SkyEngineer/sensor_current_stand/3 Elektronik/0. Datasheet/ST-LINK V2 China pinout.bmp

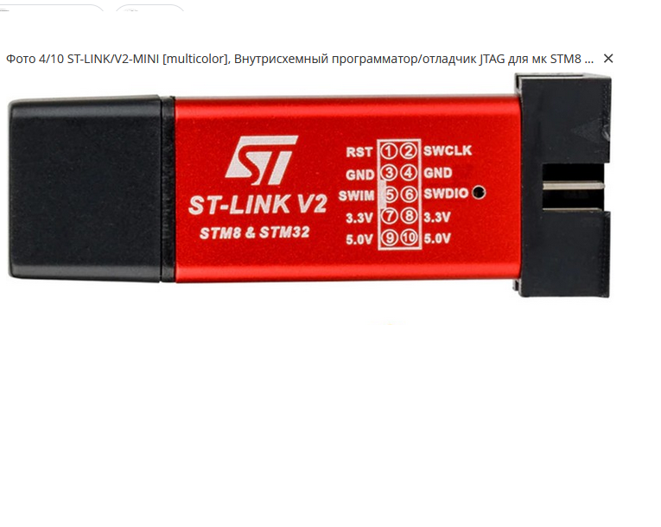
3 Elektronik/0. Datasheet/ST-LINK V2 China pinout.bmp
