SkyEngineer/sensor_current_stand/Mail/19.04.2024/Перспектива.bmp

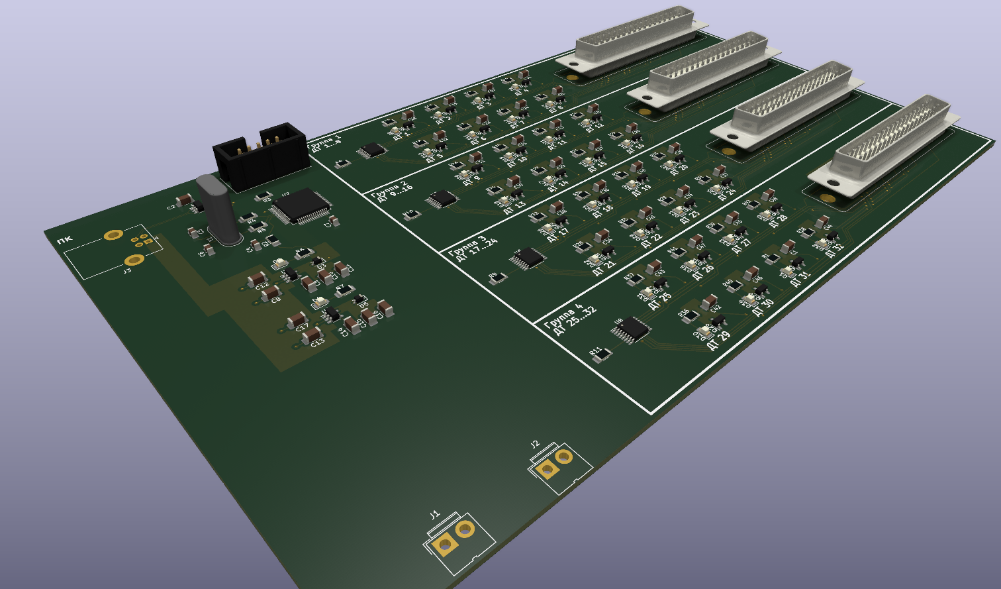
Mail/19.04.2024/Перспектива.bmp
