SkyEngineer/sensor_current_stand/3 Elektronik/Probe/Readme.txt

экспериментируем чтобы понять какое падение напряжения будет при тока в 40 мА максимум.

У меня есть только источник 5 В, для получения тока в 40 мА нужно взять сопротивление нагрузки в 5/0,040 = 125 Ом.
