SkyEngineer/sensor_current_stand/5_Soft/1. Embedded_SW/0. Beispielen/Readme.txt

Keil
https://rutracker.org/forum/viewtopic.php?t=6294452

USB
https://microtechnics.ru/mikrokontroller-stm32-i-usb/

https://microtechnics.ru/stm32cube-i-usb-virtual-com-port/
