SkyEngineer/sensor_current_stand/5_Soft/2_Desktop_SW/Работа с приборами.docx

# 1 Вольтметр

Идентификация:

Получение данных замера постоянного напряжения:

MEASure[:VOLTage]:{AC|DC}?

MEAS:VOLT:DC?

Рестарт измерений

CALCulate:CLEar[:IMMediate]

Шкала

Конфигурация измерений

CONFigure[:VOLTage]:{AC|DC} [{<range>|AUTO|MIN|MAX|DEF}]

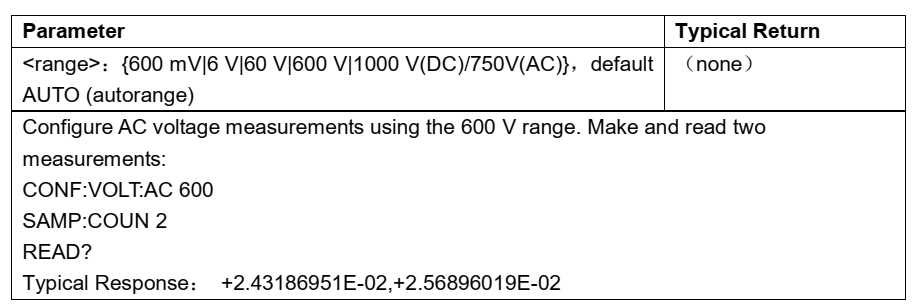
[picture p3: figure]

Выбор измерения

FUNC "VOLT:DC”

# 2 Источник измеряемого тока

# 3 Источник питания датчиков
