SkyEngineer/sensor_current_stand/со стенда/DT_100_Autotest/Template/Template_report.xlsx

Sheet: Данные
Номер датчика | Исправность датчика | Uпит, В | Iпит, mA | Uизм, В (0 А) | Uизм, В (20 А) | Uизм, В (40 А) | Uизм, В (60 А) | Uизм, В (80 А) | Uизм, В (100 А)

Sheet: Доп. данные
Время | Действие
