SkyEngineer/sensor_current_stand/со стенда/DT_500_Autotest/Template/Template_report.xlsx

Sheet: Данные
Номер датчика | Исправность датчика | Uпит, В | Iпит, mA | Uизм, В (0 А) | Uизм, В (100 А) | Uизм, В (200 А) | Uизм, В (300 А) | Uизм, В (400 А) | Uизм, В (500 А)

Sheet: Доп. данные
Время | Действие
