SkyEngineer/sensor_current_stand/5_Soft/2_Desktop_SW/DT_500_Autotest v2/Template/Template_report.xlsx

Sheet: Данные
Группа датчиков | Номер датчика | Исправность датчика | Uпит, В | Iпит, mA | Uизм, В (0 А) | Uизм, В (100 А) | Uизм, В (200 А) | Uизм, В (300 А) | Uизм, В (400 А) | Uизм, В (500 А)
1 | 1 |  | 16.0
 |  |  | 27.0
 |  |  | 32.0
 | 2 |  | 16.0
 |  |  | 27.0
 |  |  | 32.0
 | 3 |  | 16.0
 |  |  | 27.0
 |  |  | 32.0
 | 4 |  | 16.0
 |  |  | 27.0
 |  |  | 32.0
 | 5 |  | 16.0
 |  |  | 27.0
 |  |  | 32.0
 | 6 |  | 16.0
 |  |  | 27.0
 |  |  | 32.0
 | 7 |  | 16.0
 |  |  | 27.0
 |  |  | 32.0
 | 8 |  | 16.0
 |  |  | 27.0
 |  |  | 32.0
2 | 9 |  | 16.0
 |  |  | 27.0
 |  |  | 32.0
 | 10 |  | 16.0
 |  |  | 27.0
 |  |  | 32.0
 | 11 |  | 16.0
 |  |  | 27.0
 |  |  | 32.0
 | 12 |  | 16.0
 |  |  | 27.0
 |  |  | 32.0
 | 13 |  | 16.0
 |  |  | 27.0
 |  |  | 32.0
 | 14 |  | 16.0
 |  |  | 27.0
 |  |  | 32.0
 | 15 |  | 16.0
 |  |  | 27.0
 |  |  | 32.0
 | 16 |  | 16.0
 |  |  | 27.0
 |  |  | 32.0
3 | 17 |  | 16.0
 |  |  | 27.0
 |  |  | 32.0
 | 18 |  | 16.0
 |  |  | 27.0
 |  |  | 32.0
 | 19 |  | 16.0
 |  |  | 27.0
 |  |  | 32.0
 | 20 |  | 16.0
 |  |  | 27.0
 |  |  | 32.0
 | 21 |  | 16.0
 |  |  | 27.0
 |  |  | 32.0
 | 22 |  | 16.0
 |  |  | 27.0
 |  |  | 32.0
 | 23 |  | 16.0
 |  |  | 27.0
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
