SkyEngineer/sensor_current_stand/0 Vom Auftraggeber/17.05.2024/Внешний вид платы.bmp

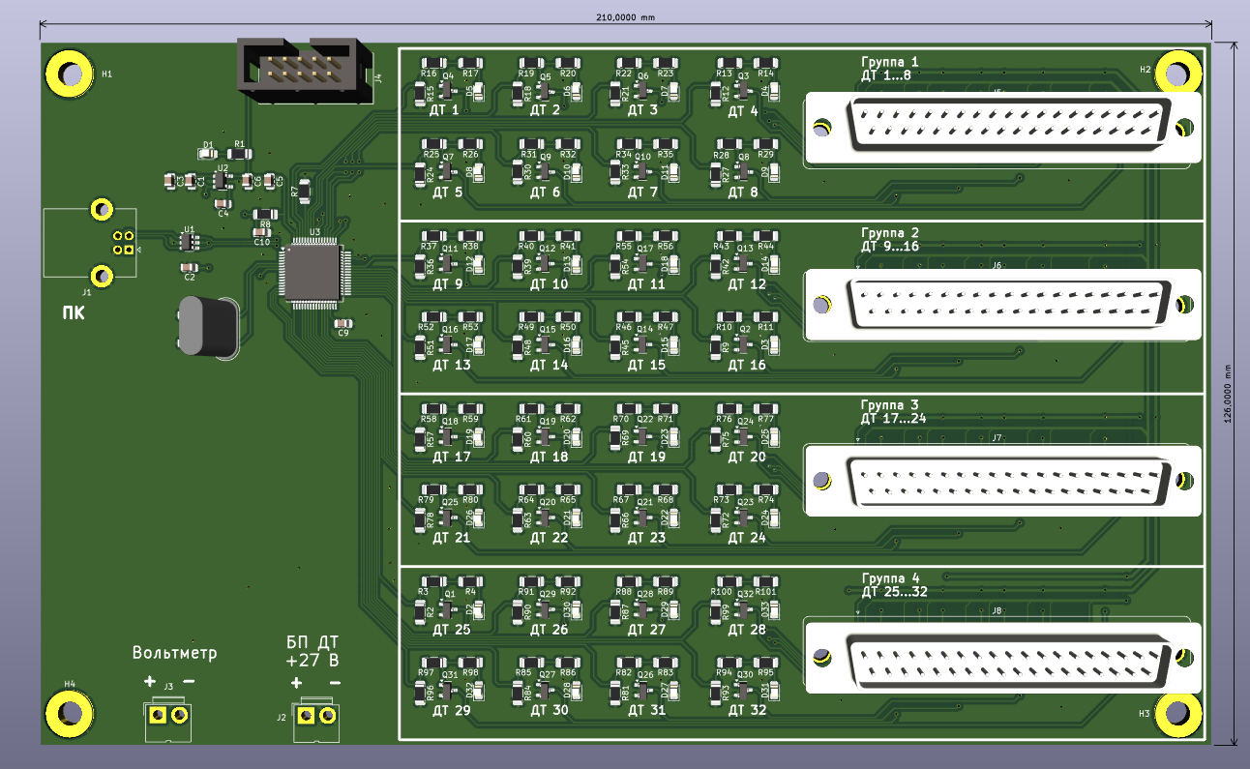
0 Vom Auftraggeber/17.05.2024/Внешний вид платы.bmp
