SkyEngineer/sensor_current_stand/3 Elektronik/Предварительное изготовление платы РЕЗОНИТ.bmp

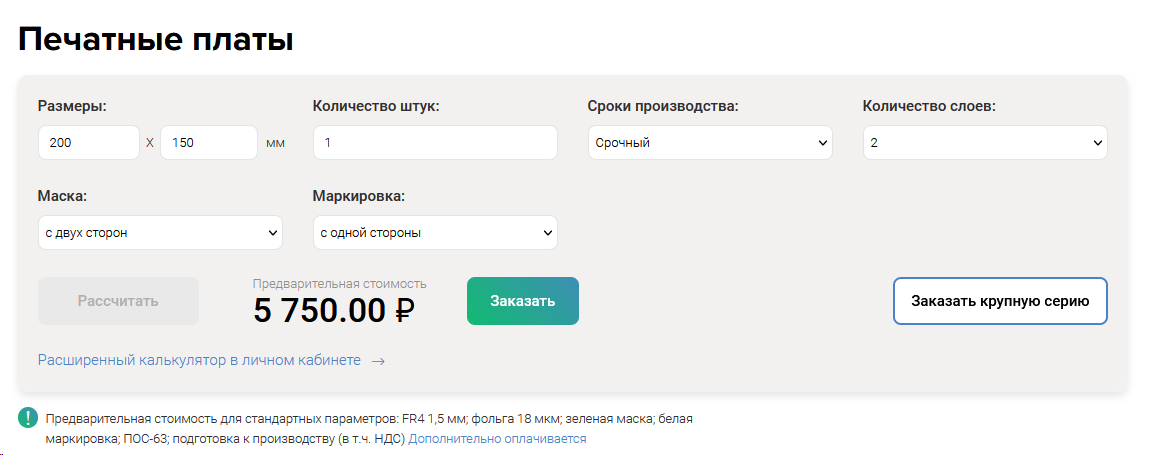
3 Elektronik/Предварительное изготовление платы РЕЗОНИТ.bmp
