SkyEngineer/sensor_current_stand/Mail/19.04.2024/Вид сверху.bmp

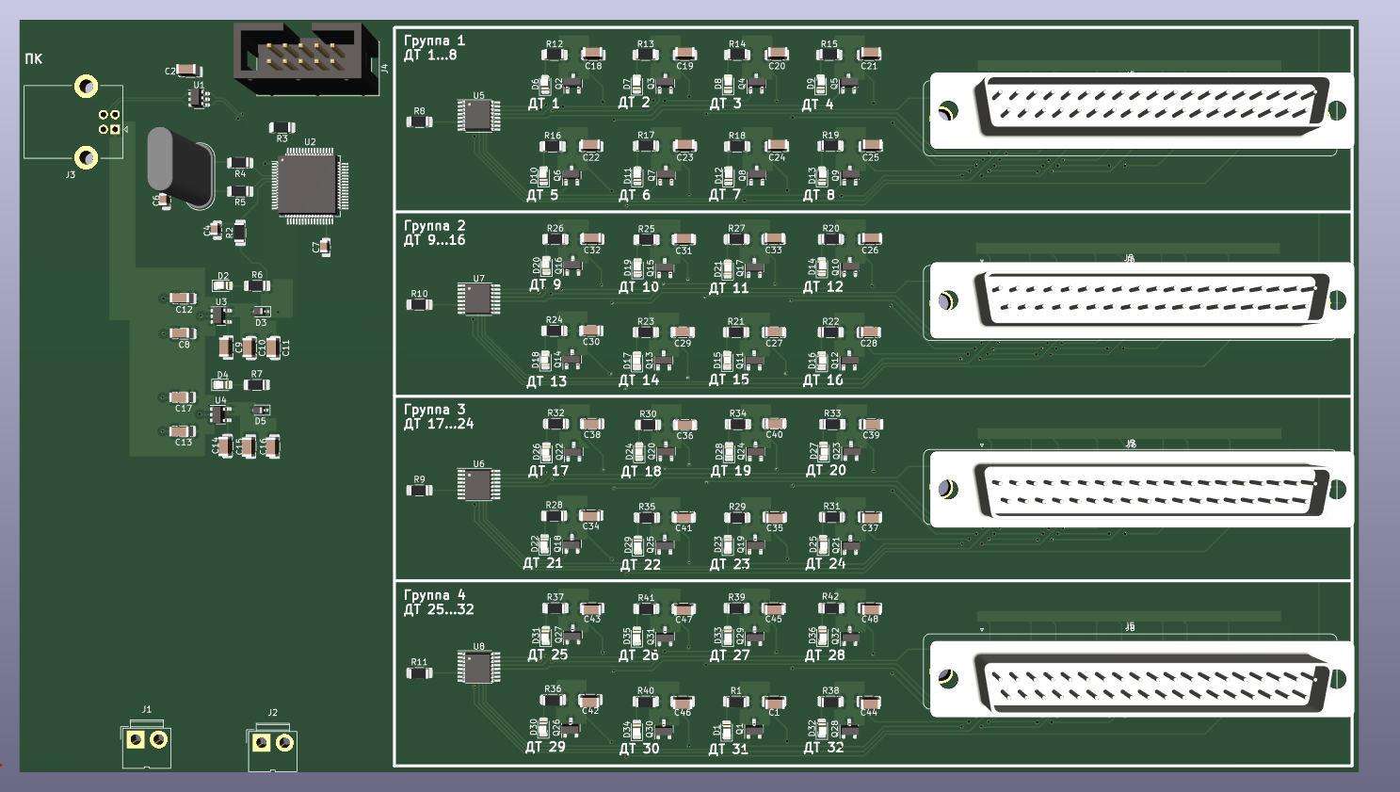
Mail/19.04.2024/Вид сверху.bmp
