SkyEngineer/sensor_current_stand/3 Elektronik/Предварительный BOM.xlsx

№ | Наименование | Назначение | Количество, шт. | цена, руб | Итог | Примечание
1 | 1734346-1, Разъем USB B SMD | Обмен стенда и ПК | 1 | 240 | 240 | https://www.chipdip.ru/product/1734346-1-te
2 | 305-021-12(TB-02A), Клеммник 2-контактный, 5мм, прямой (https://www.chipdip.ru/product/305-021-12-tb-02a) | Клеммники на плату - для питания датчиков тока - для подключения вольтметра | 2 | 21 | 42 | https://www.chipdip.ru/product/305-021-12-tb-02a
3 | DPBS-37M (DS1034 37M), Вилка на плату 37pin (https://www.chipdip.ru/product/dpbs-37m) | Подключение датчиков тока | 4 | 70 | 280 | https://www.chipdip.ru/product/dpbs-37m
4 | 74HC4051M/TR, Восьмиканальный мультиплексор/ демультиплексор | управление ключами групп | 4 | 16 | 64 | https://www.chipdip.ru/product/74hc4051m-tr
5 | BAT60JFILM, Диод Шоттки 3А, 10В [SOD-323] | Защита питания USB | 4 | 18 | 72 | https://www.chipdip.ru/product/bat60jfilm
6 | 0.25Вт 1206 100 кОм, 5%, Чип резистор (SMD) | Токоограничивающие резисторы | 20 | 6 | 120 | https://www.chipdip.ru/product/0.25w-1206-100-kom-5
7 | 0.25Вт 1206 22 Ом, 5%, Чип резистор (SMD) | Токоограничивающие резисторы | 20 | 6 | 120 | https://www.chipdip.ru/product/0.25w-1206-22-om-5
8 | STM32F446RET6, Микроконтроллер ARM Cortex-M4 32-Бит 180МГц 512КБ FLASH LQFP-64(10x10) | МК | 1 | 1760 | 1760 | https://www.chipdip.ru/product/stm32f446ret6
9 | BH-10 (DS1013-10S) (IDC-10MS), Вилка на плату прямая 10pin 2.54мм | Разъем загрузки ПО и отладки ПО | 2 | 9 | 18 | https://www.chipdip.ru/product/idc-10ms
10 | LD3985M33R, Регулятор с низким падением напряжения и уровнем шума, 150мА, 3.3В | Питание МК и мультиплексоров | 2 | 90 | 180 | https://www.chipdip.ru/product/ld3985m33r
11 | KP-2012MGC, Светодиод зеленый 2х1.2х1.1мм 50мКд | Светодиоды для контроля включения датчиков и питания | 40 | 36 | 1440 | https://www.chipdip.ru/product/kp-2012mgc
12 | IRF7342TR, Транзистор 2P-MOSFET 55В 3.4А 2Вт [SOP-8] | Ключи питания | 32 | 39 | 1248 | https://www.chipdip.ru/product/irf7342tr
 |  |  |  |  | 5584
