SkyEngineer/sensor_current_stand/0 Vom Auftraggeber/28.03.2024 Описание/project УПП/ПЭ3-УПП.xls

Sheet: . Первый лист.
Перв. примен. | Поз. обозна-чение |  |  | Наименование |  |  |  | Кол. |  | Примечание
 |  |  |  | Реле
 | K1-K20 |  |  | Микротумблер MTS-101 A-2 |  |  |  | 20
Справ. № |  |  |  | Вилки
 | XP1 |  |  | Разъём PLD-20 |  |  |  | 1
 | XP2-XP20 |  |  | Разъём PLS-1 |  |  |  | 19
 |  |  |  | Розетки
 | XS1 |  |  | Клеммник 305-021-12 |  |  |  | 1
 | XS2 |  |  | Разъём BNC-7044 |  |  |  | 1
 | XS3 |  |  | Клеммник 305-021-12 |  |  |  | 1
Подп. и дата | XS4 |  |  | Клеммник 300-41-12 |  |  |  | 1
Инв. № дубл. | K21_3,K21_4 |  |  | Микротумблер MTS-101 A-2 |  |  |  | 2
 | K21_1,K21_2 |  |  | Микротумблер MTS-101 A-2 |  |  |  | 2
 | K23_3,K23_4 |  |  | Реле IM03TS |  |  |  | 2
Взам. инв.№ | K23_1,K23_2 |  |  | Реле IM03TS |  |  |  | 2
 | K24_3,K24_4 |  |  | Реле IM03TS |  |  |  | 2
Подп. и дата
 |  |  |  |  |  |  | ПЭ3
 | Изм. | Лист | № докум. |  | Подп. | Дата
Инв. № подл. | Разраб. |  |  |  |  |  |  |  | Лит. |  | Лист | Листов
 | Пров. |  |  |  |  |  |  |  |  |  | 1 | 5
 | Н.контр
 | Утв. |  |  |  |  |  | Перечень элементов

Sheet: 2
 | Поз. обозна- чение |  |  | Наименование |  |  |  | Кол. | Примечание
 | K24_1,K24_2 |  |  | Реле IM03TS |  |  |  | 2
 | K25_3,K25_4 |  |  | Реле IM03TS |  |  |  | 2
 | K25_1,K25_2 |  |  | Реле IM03TS |  |  |  | 2
 | K26_3,K26_4 |  |  | Реле IM03TS |  |  |  | 2
 | K26_1,K26_2 |  |  | Реле IM03TS |  |  |  | 2
 | K27_3,K27_4 |  |  | Реле IM03TS |  |  |  | 2
 | K27_1,K27_2 |  |  | Реле IM03TS |  |  |  | 2
 | K28_3,K28_4 |  |  | Реле IM03TS |  |  |  | 2
 | K28_1,K28_2 |  |  | Реле IM03TS |  |  |  | 2
 | K29_3,K29_4 |  |  | Реле IM03TS |  |  |  | 2
 | K29_1,K29_2 |  |  | Реле IM03TS |  |  |  | 2
 | K30_3,K30_4 |  |  | Реле IM03TS |  |  |  | 2
Подп. и дата | K30_1,K30_2 |  |  | Реле IM03TS |  |  |  | 2
 | K31_3,K31_4 |  |  | Реле IM03TS |  |  |  | 2
 | K31_1,K31_2 |  |  | Реле IM03TS |  |  |  | 2
 | K32_3,K32_4 |  |  | Реле IM03TS |  |  |  | 2
Инв. № дубл. | K32_1,K32_2 |  |  | Реле IM03TS |  |  |  | 2
 | K33_3,K33_4 |  |  | Реле IM03TS |  |  |  | 2
 | K33_1,K33_2 |  |  | Реле IM03TS |  |  |  | 2
Взам. инв.№ | K34_3,K34_4 |  |  | Реле IM03TS |  |  |  | 2
 | K34_1,K34_2 |  |  | Реле IM03TS |  |  |  | 2
 | K35_3,K35_4 |  |  | Реле IM03TS |  |  |  | 2
Подп. и дата | K35_1,K35_2 |  |  | Реле IM03TS |  |  |  | 2
 | K36_3,K36_4 |  |  | Реле IM03TS |  |  |  | 2
 | K36_1,K36_2 |  |  | Реле IM03TS |  |  |  | 2
 | K37_3,K37_4 |  |  | Реле IM03TS |  |  |  | 2
 | K37_1,K37_2 |  |  | Реле IM03TS |  |  |  | 2
Инв. № подл. | K38_3,K38_4 |  |  | Реле IM03TS |  |  |  | 2
 |  |  |  |  |  |  | ПЭ3 |  |  | Лист
 |  |  |  |  |  |  |  |  |  | 2
 | Изм. | Лист | № докум. |  | Подп. | Дата

Sheet: 3
 | Поз. обозна- чение |  |  | Наименование |  |  |  | Кол. | Примечание
 | K38_1,K38_2 |  |  | Реле IM03TS |  |  |  | 2
 | K39_3,K39_4 |  |  | Реле IM03TS |  |  |  | 2
 | K39_1,K39_2 |  |  | Реле IM03TS |  |  |  | 2
 | K40_3,K40_4 |  |  | Реле IM03TS |  |  |  | 2
 | K40_1,K40_2 |  |  | Реле IM03TS |  |  |  | 2
 | K41_3,K41_4 |  |  | Реле IM03TS |  |  |  | 2
 | K41_1,K41_2 |  |  | Реле IM03TS |  |  |  | 2
 | K42_3,K42_4 |  |  | Реле IM03TS |  |  |  | 2
 | K42_1,K42_2 |  |  | Реле IM03TS |  |  |  | 2
 | K43_3,K43_4 |  |  | Реле IM03TS |  |  |  | 2
 | K43_1,K43_2 |  |  | Реле IM03TS |  |  |  | 2
 | K44_3,K44_4 |  |  | Реле IM03TS |  |  |  | 2
Подп. и дата | K44_1,K44_2 |  |  | Реле IM03TS |  |  |  | 2
 | K45_3,K45_4 |  |  | Реле IM03TS |  |  |  | 2
 | K45_1,K45_2 |  |  | Реле IM03TS |  |  |  | 2
 | K46_3,K46_4 |  |  | Реле IM03TS |  |  |  | 2
Инв. № дубл. | K46_1,K46_2 |  |  | Реле IM03TS |  |  |  | 2
 | K47_3,K47_4 |  |  | Реле IM03TS |  |  |  | 2
 | K47_1,K47_2 |  |  | Реле IM03TS |  |  |  | 2
Взам. инв.№ | K48_3,K48_4 |  |  | Реле IM03TS |  |  |  | 2
 | K48_1,K48_2 |  |  | Реле IM03TS |  |  |  | 2
 | K49_3,K49_4 |  |  | Реле IM03TS |  |  |  | 2
Подп. и дата | K49_1,K49_2 |  |  | Реле IM03TS |  |  |  | 2
 | K50_3,K50_4 |  |  | Реле IM03TS |  |  |  | 2
 | K50_1,K50_2 |  |  | Реле IM03TS |  |  |  | 2
 | K51_3,K51_4 |  |  | Реле IM03TS |  |  |  | 2
 | K51_1,K51_2 |  |  | Реле IM03TS |  |  |  | 2
Инв. № подл. | K52_3,K52_4 |  |  | Реле IM03TS |  |  |  | 2
 |  |  |  |  |  |  | ПЭ3 |  |  | Лист
 |  |  |  |  |  |  |  |  |  | 3
 | Изм. | Лист | № докум. |  | Подп. | Дата

Sheet: 4
 | Поз. обозна- чение |  |  | Наименование |  |  |  | Кол. | Примечание
 | K52_1,K52_2 |  |  | Реле IM03TS |  |  |  | 2
 | K53_3,K53_4 |  |  | Реле IM03TS |  |  |  | 2
 | K53_1,K53_2 |  |  | Реле IM03TS |  |  |  | 2
 | K54_3,K54_4 |  |  | Реле IM03TS |  |  |  | 2
 | K54_1,K54_2 |  |  | Реле IM03TS |  |  |  | 2
 | K55_3,K55_4 |  |  | Реле IM03TS |  |  |  | 2
 | K55_1,K55_2 |  |  | Реле IM03TS |  |  |  | 2
 | K56_3,K56_4 |  |  | Реле IM03TS |  |  |  | 2
 | K56_1,K56_2 |  |  | Реле IM03TS |  |  |  | 2
 | K57_3,K57_4 |  |  | Реле IM03TS |  |  |  | 2
 | K57_1,K57_2 |  |  | Реле IM03TS |  |  |  | 2
 | K58_3,K58_4 |  |  | Реле IM03TS |  |  |  | 2
Подп. и дата | K58_1,K58_2 |  |  | Реле IM03TS |  |  |  | 2
 | K59_3,K59_4 |  |  | Реле IM03TS |  |  |  | 2
 | K59_1,K59_2 |  |  | Реле IM03TS |  |  |  | 2
 | K60_3,K60_4 |  |  | Реле IM03TS |  |  |  | 2
Инв. № дубл. | K60_1,K60_2 |  |  | Реле IM03TS |  |  |  | 2
 | XP21_3,XP21_4 |  |  | Разъём DPBS-37M |  |  |  | 2
 | XP21_1,XP21_2 |  |  | Разъём DPBS-37M |  |  |  | 2
Взам. инв.№ | XP22_3,XP22_4 |  |  | Разъём DPBS-37M |  |  |  | 2
 | XP22_1,XP22_2 |  |  | Разъём DPBS-37M |  |  |  | 2
Подп. и дата
Инв. № подл.
 |  |  |  |  |  |  | ПЭ3 |  |  | Лист
 |  |  |  |  |  |  |  |  |  | 4
 | Изм. | Лист | № докум. |  | Подп. | Дата

Sheet: Лист регистрации изменений.
 | Лист регистрации изменений
 | Изм. |  | Номера листов (страниц) |  |  |  |  |  |  |  | Всего листов (страниц) в докум. | № докум. | Входящий № сопроводи-тельного документа и дата | Под- пись | Дата
 |  |  | изменен- ных |  | заменен- ных |  | новых |  |  | аннули- рован- ных
Подп. и дата
Инв. № дубл.
Взам. инв.№
Подп. и дата
Инв. № подл.
 |  |  |  |  |  |  |  |  | ПЭ3 |  |  |  |  |  |  | Лист
 |  |  |  |  |  |  |  |  |  |  |  |  |  |  |  | 5
 | Изм. | Лист |  | № докум. |  | Подп. |  | Дата
