SkyEngineer/sensor_current_stand/5_Soft/2_Desktop_SW/Testing_DT/Readme.txt

В данном проекте используется ООП и имеются следующие объекты:
1. Технологический коммутатор (virtual com port).
2. Блок питания-измеритель для питания датчиков тока GPP-74323.
3. Блок питания-измеритель для формирования проверямого тока АКИП 1162-10-1020 или АКИП-1162-10-510 (???).
4. Вольтметр АКИП-21011 ()
