SkyEngineer/sensor_current_stand/5_Soft/2_Desktop_SW/test/pythonProject/readme.txt

    download the latest libusb Download libusb

Copy MS32\dll\libusb-1.0.dll to C:\Windows\SysWOW64

Copy MS64\dll\libusb-1.0.dll to C:\Windows\System32

3.

pip install libusb

Copy MS32\dll\libusb-1.0.dll to C:\Python\Python37-32\Lib\site-packages\libusb_platform_windows\x86

Copy MS64\dll\libusb-1.0.dll to C:\Python\Python37-32\Lib\site-packages\libusb_platform_windows\x64

This method works for me.
