SkyEngineer/sensor_current_stand/(list of files, drawings)

Other design files:
0 Vom Auftraggeber/28.03.2024 Описание/project УПП/Группа 1.SchDoc
0 Vom Auftraggeber/28.03.2024 Описание/project УПП/Группа 2.SchDoc
0 Vom Auftraggeber/28.03.2024 Описание/project УПП/Группа 3.SchDoc
0 Vom Auftraggeber/28.03.2024 Описание/project УПП/Группа 4.SchDoc
0 Vom Auftraggeber/28.03.2024 Описание/project УПП/УПП.PrjPcb
0 Vom Auftraggeber/28.03.2024 Описание/project УПП/УПП.SchDoc
