SkyEngineer/sensor_current_stand/3 Elektronik/sensor_current_stand/sensor_current_stand/sensor_current_stand.kicad_pcb

## KiCad design 3 Elektronik/sensor_current_stand/sensor_current_stand/sensor_current_stand.kicad_pcb (2024-05-13)

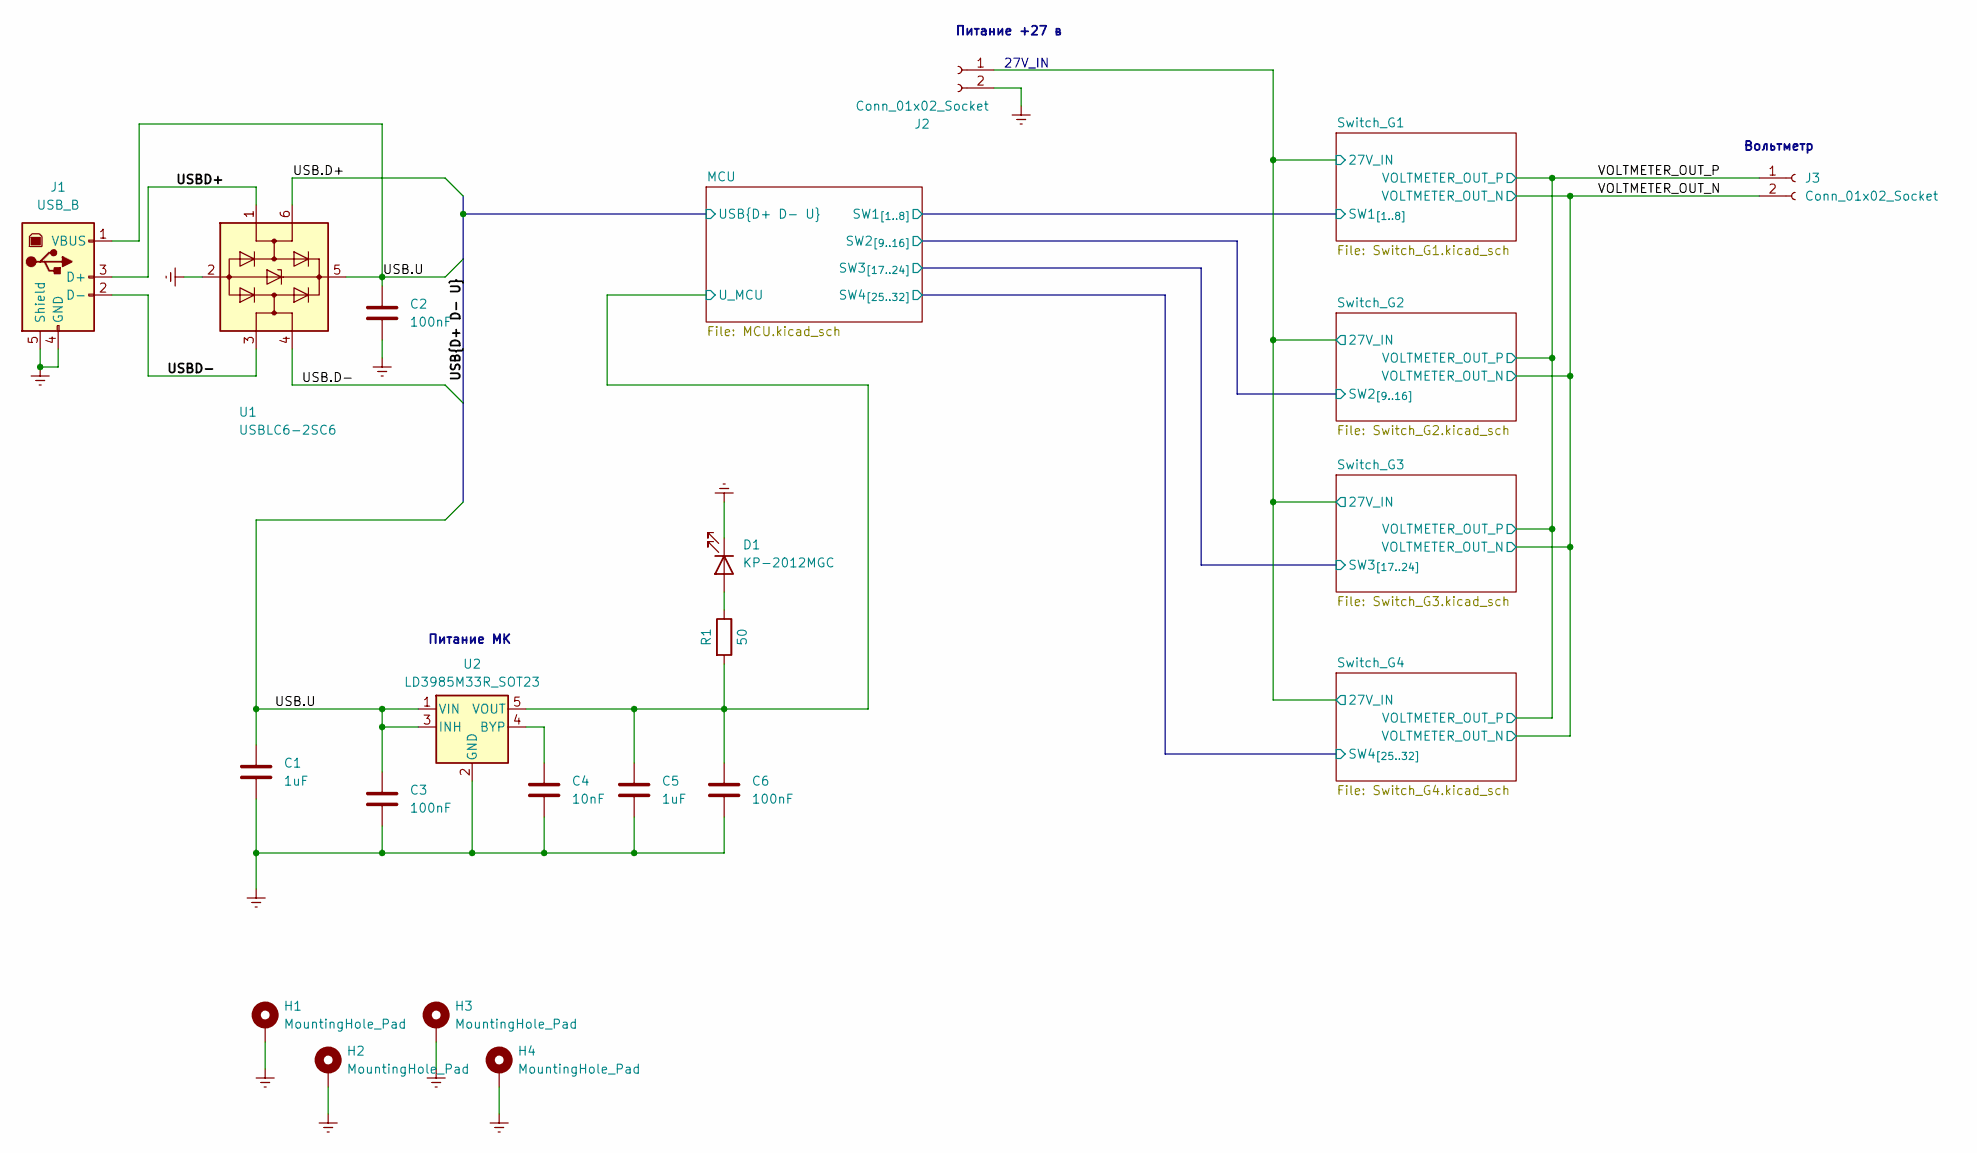
[picture p12: schematic sensor_current_stand.kicad_sch]

Parts:
C1, C5: 1uF; C_0805_2012Metric
C2, C3, C6: 100nF; C_0805_2012Metric
C4: 10nF; C_0805_2012Metric
D1: KP-2012MGC; LED_0805_2012Metric_Pad1.15x1.40mm_HandSolder
H1, H2, H3, H4: MountingHole_Pad; MountingHole_4.3mm_M4_Pad_TopBottom
J1: USB_B; USB_B_Lumberg_2411_02_Horizontal
J2, J3: Conn_01x02_Socket; JWT_A3963_1x02_P3.96mm_Vertical
R1: 50; R_1206_3216Metric_Pad1.30x1.75mm_HandSolder
U1: USBLC6-2SC6; SOT-23-6
U2: LD3985M33R_SOT23; SOT-23-5

Connections:
/MCU/U_MCU: C5.1, C6.1, R1.2, U2.5 (VOUT); also elsewhere on the board
/Switch_G1/27V_IN: J2.1; also elsewhere on the board
/USB.D+: U1.6 (I/O1); also elsewhere on the board
/USB.D-: U1.4 (I/O2); also elsewhere on the board
/USB.U: C1.1, C2.1, C3.1, J1.1 (VBUS), U1.5 (VBUS), U2.1 (VIN), U2.3 (INH)
/USBD+: J1.3 (D+), U1.1 (I/O1)
/USBD-: J1.2 (D-), U1.3 (I/O2)
/VOLTMETER_OUT_N: J3.2; also elsewhere on the board
/VOLTMETER_OUT_P: J3.1; also elsewhere on the board
Earth: C1.2, C2.2, C3.2, C4.2, C5.2, C6.2, D1.1 (K), H1.1, H2.1, H3.1, H4.1, J1.4 (GND), J1.5 (Shield), J2.2, U1.2 (GND), U2.2 (GND); also elsewhere on the board
unnamed: D1.2 (A), R1.1
unnamed: C4.1, U2.4 (BYP)

Notes on the sheet:
27V_IN
Вольтметр
Питание +27 в
Питание МК

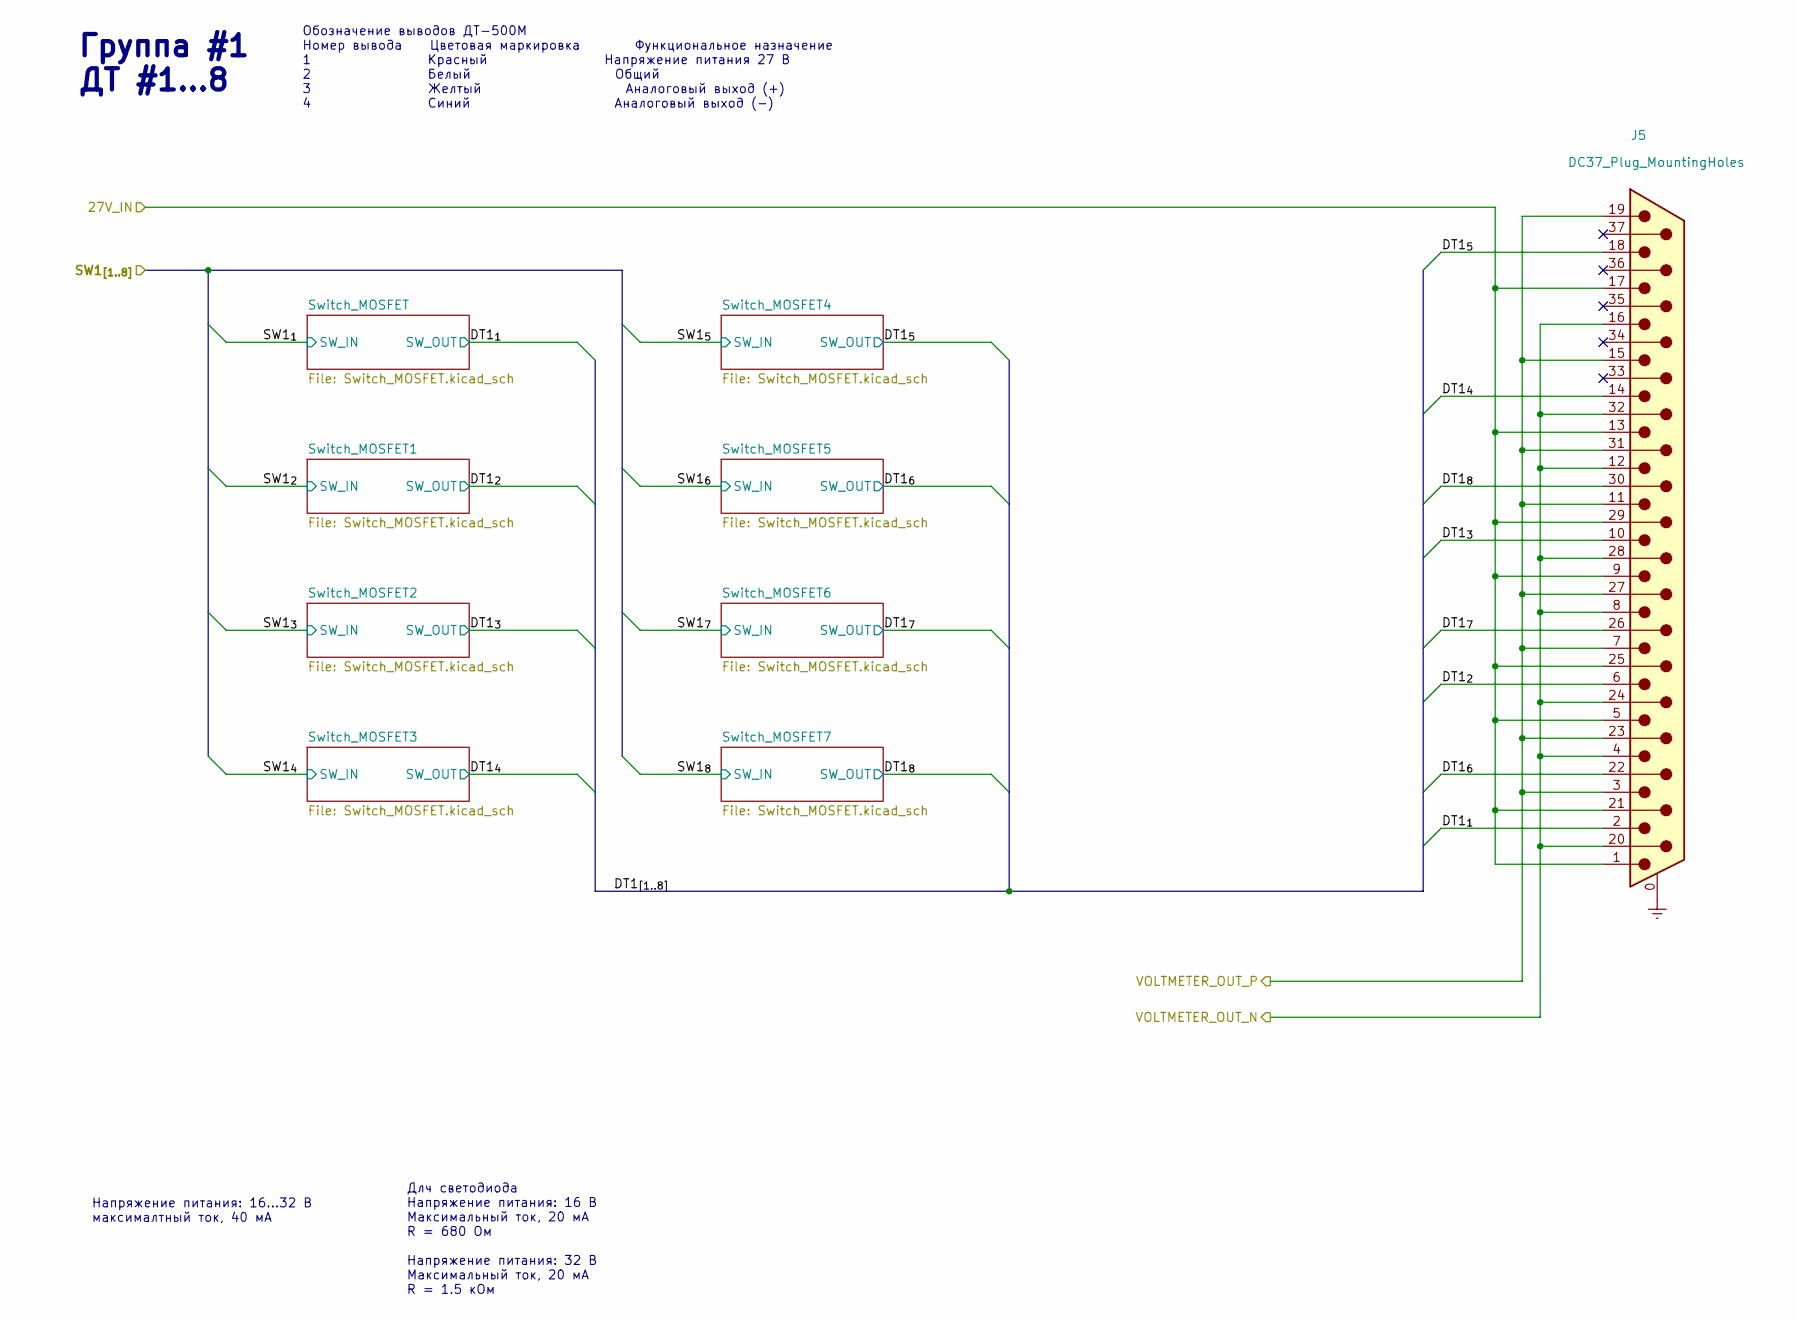
[picture p13: schematic Switch_G1.kicad_sch]

Parts:
J5: DC37_Plug_MountingHoles; DSUB-37_Male_Vertical_P2.77x2.84mm_MountingHoles

Connections:
/Switch_G1/27V_IN: J5.1, J5.5, J5.9, J5.13, J5.17, J5.21, J5.25, J5.29; also elsewhere on the board
/Switch_G1/DT1_{1}: J5.2; also elsewhere on the board
/Switch_G1/DT1_{2}: J5.6; also elsewhere on the board
/Switch_G1/DT1_{3}: J5.10; also elsewhere on the board
/Switch_G1/DT1_{4}: J5.14; also elsewhere on the board
/Switch_G1/DT1_{5}: J5.18; also elsewhere on the board
/Switch_G1/DT1_{6}: J5.22; also elsewhere on the board
/Switch_G1/DT1_{7}: J5.26; also elsewhere on the board
/Switch_G1/DT1_{8}: J5.30; also elsewhere on the board
/VOLTMETER_OUT_N: J5.4, J5.8, J5.12, J5.16, J5.20, J5.24, J5.28, J5.32; also elsewhere on the board
/VOLTMETER_OUT_P: J5.3, J5.7, J5.11, J5.15, J5.19, J5.23, J5.27, J5.31; also elsewhere on the board
Earth: J5.0 (PAD); also elsewhere on the board

Notes on the sheet:
Обозначение выводов ДТ-500М Номер вывода Цветовая маркировка Функциональное назначение 1 Красный Напряжение питания 27 В 2 Белый Общий 3 Желтый Аналоговый выход (+) 4 Синий Аналоговый выход (-)
Группа #1 ДТ #1...8
Длч светодиода Напряжение питания: 16 В Максимальный ток, 20 мА R = 680 Ом Напряжение питания: 32 В Максимальный ток, 20 мА R = 1.5 кОм
Напряжение питания: 16...32 В максималтный ток, 40 мА

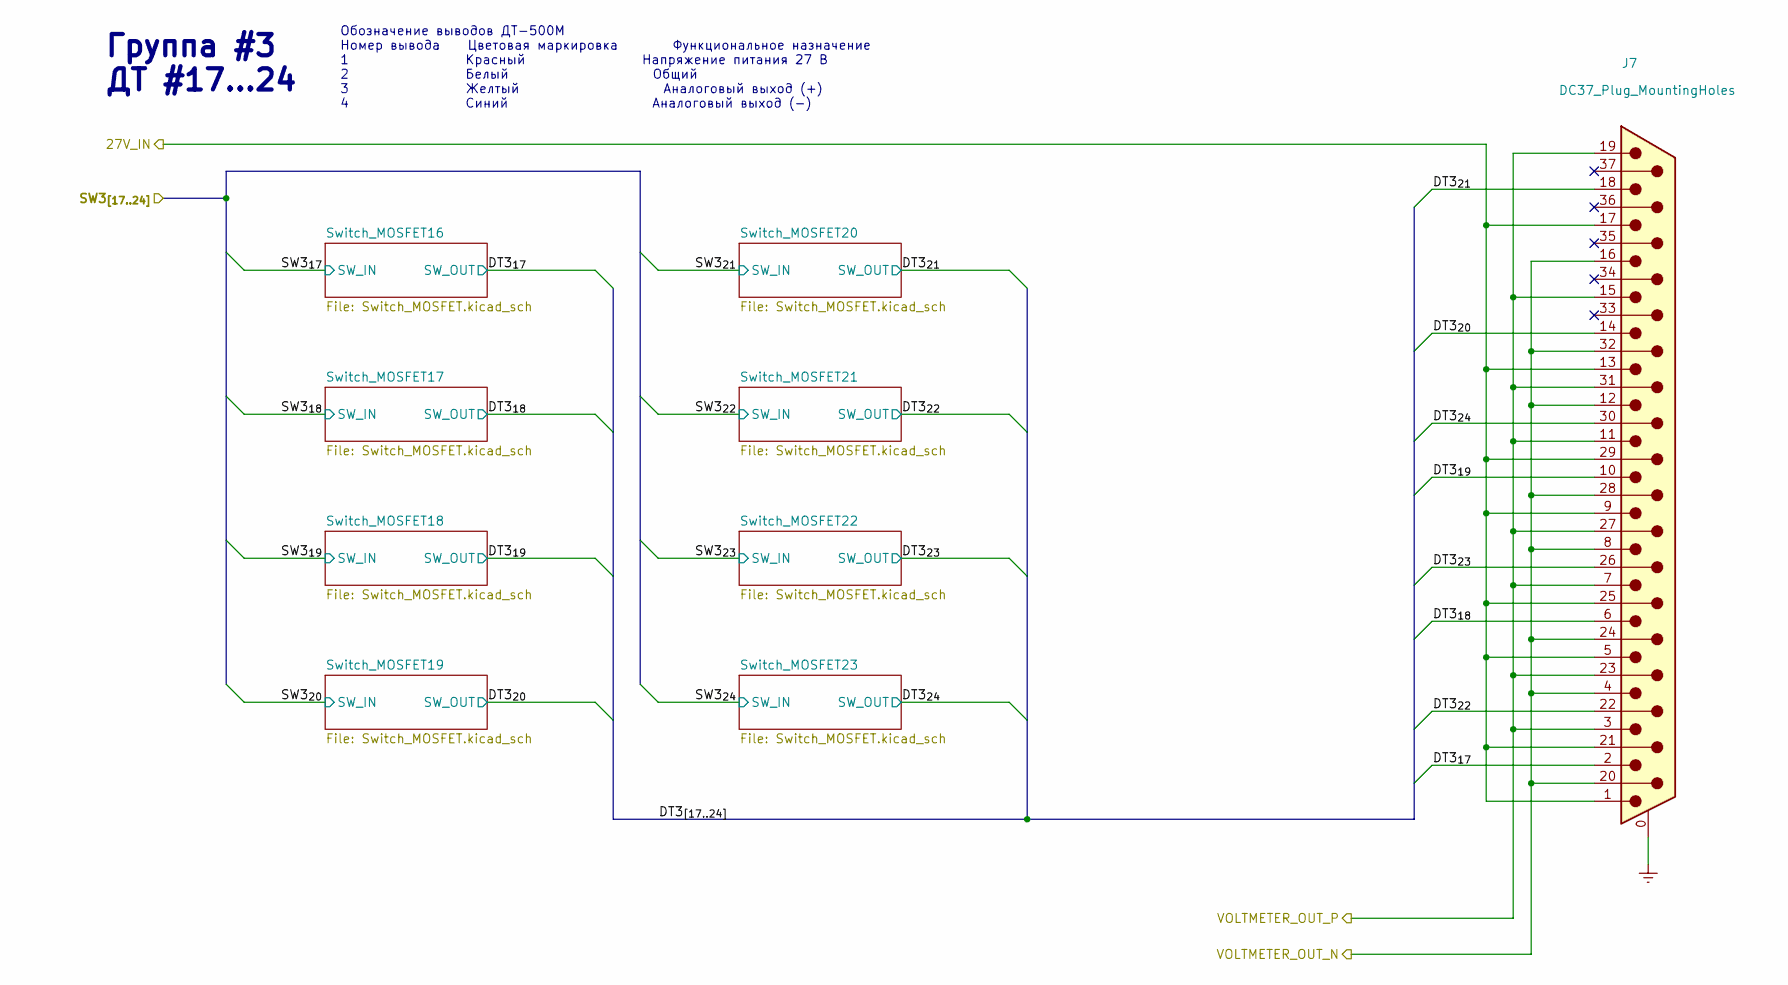
[picture p14: schematic Switch_G3.kicad_sch]

Parts:
J7: DC37_Plug_MountingHoles; DSUB-37_Male_Vertical_P2.77x2.84mm_MountingHoles

Connections:
/Switch_G1/27V_IN: J7.1, J7.5, J7.9, J7.13, J7.17, J7.21, J7.25, J7.29; also elsewhere on the board
/Switch_G3/DT3_{17}: J7.2; also elsewhere on the board
/Switch_G3/DT3_{18}: J7.6; also elsewhere on the board
/Switch_G3/DT3_{19}: J7.10; also elsewhere on the board
/Switch_G3/DT3_{20}: J7.14; also elsewhere on the board
/Switch_G3/DT3_{21}: J7.18; also elsewhere on the board
/Switch_G3/DT3_{22}: J7.22; also elsewhere on the board
/Switch_G3/DT3_{23}: J7.26; also elsewhere on the board
/Switch_G3/DT3_{24}: J7.30; also elsewhere on the board
/VOLTMETER_OUT_N: J7.4, J7.8, J7.12, J7.16, J7.20, J7.24, J7.28, J7.32; also elsewhere on the board
/VOLTMETER_OUT_P: J7.3, J7.7, J7.11, J7.15, J7.19, J7.23, J7.27, J7.31; also elsewhere on the board
Earth: J7.0 (PAD); also elsewhere on the board

Notes on the sheet:
Группа #3 ДТ #17...24
Обозначение выводов ДТ-500М Номер вывода Цветовая маркировка Функциональное назначение 1 Красный Напряжение питания 27 В 2 Белый Общий 3 Желтый Аналоговый выход (+) 4 Синий Аналоговый выход (-)

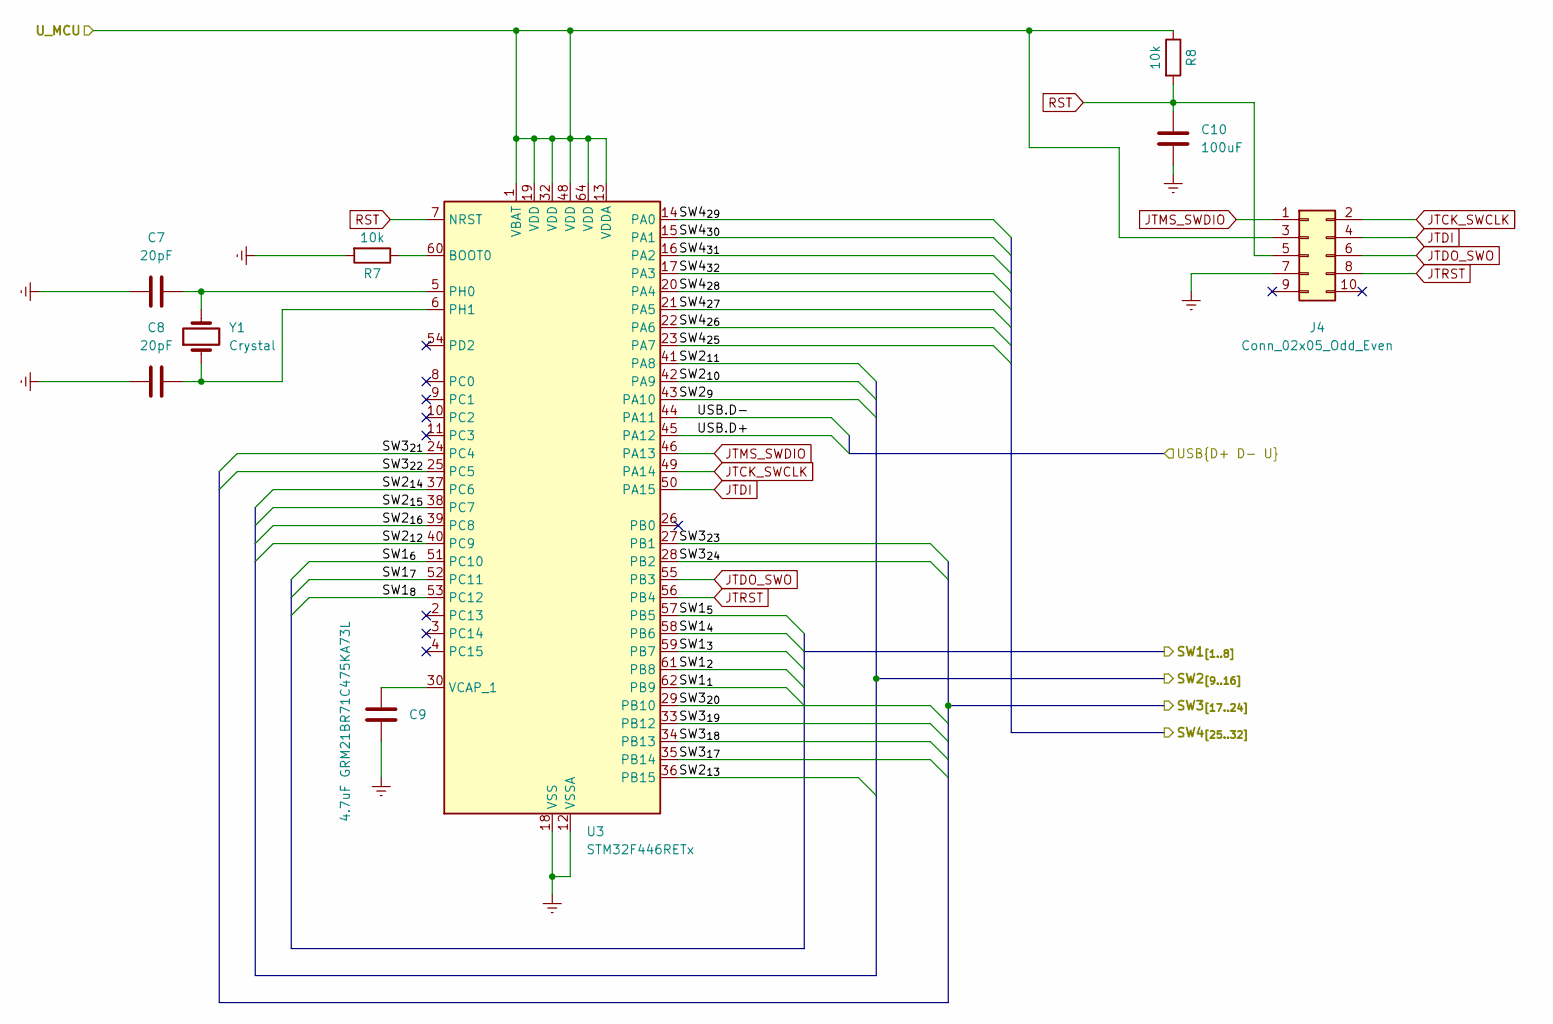
[picture p15: schematic MCU.kicad_sch]

Parts:
C7, C8: 20pF; C_0805_2012Metric_Pad1.18x1.45mm_HandSolder
C9: 4.7uF GRM21BR71C475KA73L; C_0805_2012Metric_Pad1.18x1.45mm_HandSolder
C10: 100uF; C_0805_2012Metric_Pad1.18x1.45mm_HandSolder
J4: Conn_02x05_Odd_Even; IDC-Header_2x05_P2.54mm_Vertical
R7, R8: 10k; R_1206_3216Metric_Pad1.30x1.75mm_HandSolder
U3: STM32F446RETx; LQFP-64_10x10mm_P0.5mm
Y1: Crystal; Crystal_HC49-U_Vertical

Connections:
/MCU/SW1_{1}: U3.62 (PB9); also elsewhere on the board
/MCU/SW1_{2}: U3.61 (PB8); also elsewhere on the board
/MCU/SW1_{3}: U3.59 (PB7); also elsewhere on the board
/MCU/SW1_{4}: U3.58 (PB6); also elsewhere on the board
/MCU/SW1_{5}: U3.57 (PB5); also elsewhere on the board
/MCU/SW1_{6}: U3.51 (PC10); also elsewhere on the board
/MCU/SW1_{7}: U3.52 (PC11); also elsewhere on the board
/MCU/SW1_{8}: U3.53 (PC12); also elsewhere on the board
/MCU/SW2_{9}: U3.43 (PA10); also elsewhere on the board
/MCU/SW2_{10}: U3.42 (PA9); also elsewhere on the board
/MCU/SW2_{11}: U3.41 (PA8); also elsewhere on the board
/MCU/SW2_{12}: U3.40 (PC9); also elsewhere on the board
/MCU/SW2_{13}: U3.36 (PB15); also elsewhere on the board
/MCU/SW2_{14}: U3.37 (PC6); also elsewhere on the board
/MCU/SW2_{15}: U3.38 (PC7); also elsewhere on the board
/MCU/SW2_{16}: U3.39 (PC8); also elsewhere on the board
/MCU/SW3_{17}: U3.35 (PB14); also elsewhere on the board
/MCU/SW3_{18}: U3.34 (PB13); also elsewhere on the board
/MCU/SW3_{19}: U3.33 (PB12); also elsewhere on the board
/MCU/SW3_{20}: U3.29 (PB10); also elsewhere on the board
/MCU/SW3_{21}: U3.24 (PC4); also elsewhere on the board
/MCU/SW3_{22}: U3.25 (PC5); also elsewhere on the board
/MCU/SW3_{23}: U3.27 (PB1); also elsewhere on the board
/MCU/SW3_{24}: U3.28 (PB2); also elsewhere on the board
/MCU/SW4_{25}: U3.23 (PA7); also elsewhere on the board
/MCU/SW4_{26}: U3.22 (PA6); also elsewhere on the board
/MCU/SW4_{27}: U3.21 (PA5); also elsewhere on the board
/MCU/SW4_{28}: U3.20 (PA4); also elsewhere on the board
/MCU/SW4_{29}: U3.14 (PA0); also elsewhere on the board
/MCU/SW4_{30}: U3.15 (PA1); also elsewhere on the board
/MCU/SW4_{31}: U3.16 (PA2); also elsewhere on the board
/MCU/SW4_{32}: U3.17 (PA3); also elsewhere on the board
/MCU/U_MCU: J4.3, R8.1, U3.1 (VBAT), U3.13 (VDDA), U3.19 (VDD), U3.32 (VDD), U3.48 (VDD), U3.64 (VDD); also elsewhere on the board
/USB.D+: U3.45 (PA12); also elsewhere on the board
/USB.D-: U3.44 (PA11); also elsewhere on the board
Earth: C7.1, C8.1, C9.1, C10.1, J4.7, R7.2, U3.12 (VSSA), U3.18 (VSS), U3.31 (VSS), U3.47 (VSS), U3.63 (VSS); also elsewhere on the board
JTCK_SWCLK: J4.2, U3.49 (PA14)
JTDI: J4.4, U3.50 (PA15)
JTDO_SWO: J4.6, U3.55 (PB3)
JTMS_SWDIO: J4.1, U3.46 (PA13)
JTRST: J4.8, U3.56 (PB4)
unnamed: R7.1, U3.60 (BOOT0)
unnamed: C7.2, U3.5 (PH0), Y1.2
unnamed: C8.2, U3.6 (PH1), Y1.1
unnamed: C9.2, U3.30 (VCAP_1)
RST: C10.2, J4.5, R8.2, U3.7 (NRST)

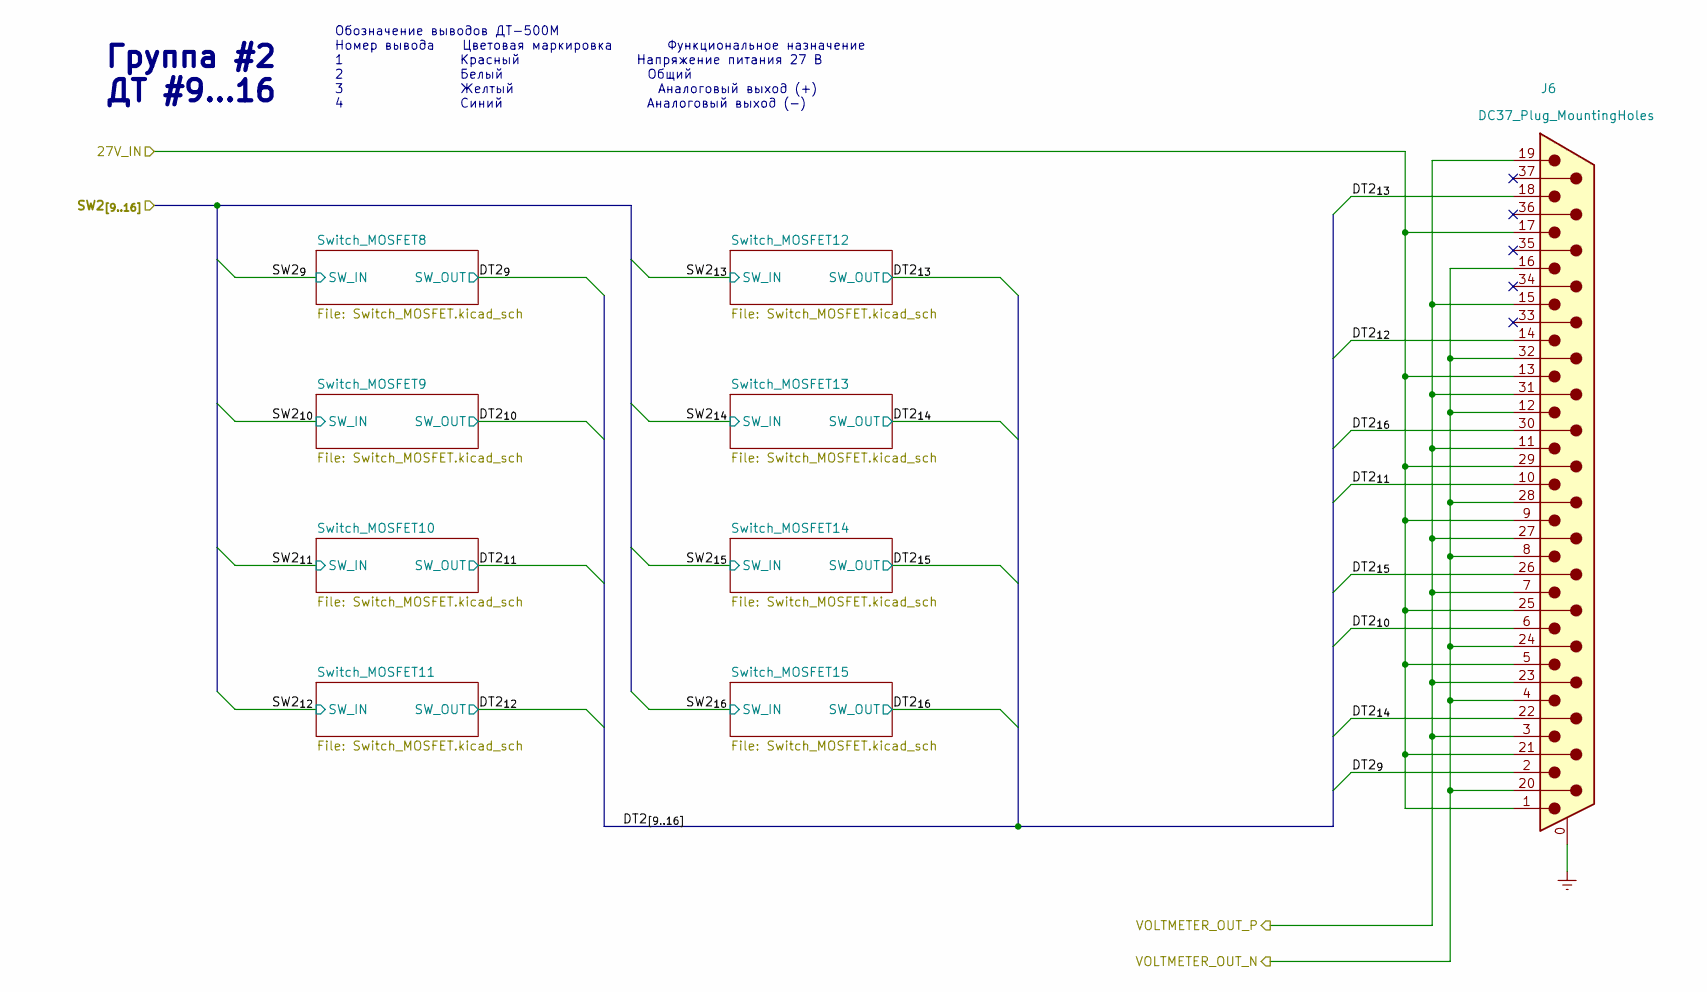
[picture p16: schematic Switch_G2.kicad_sch]

Parts:
J6: DC37_Plug_MountingHoles; DSUB-37_Male_Vertical_P2.77x2.84mm_MountingHoles

Connections:
/Switch_G1/27V_IN: J6.1, J6.5, J6.9, J6.13, J6.17, J6.21, J6.25, J6.29; also elsewhere on the board
/Switch_G2/DT2_{9}: J6.2; also elsewhere on the board
/Switch_G2/DT2_{10}: J6.6; also elsewhere on the board
/Switch_G2/DT2_{11}: J6.10; also elsewhere on the board
/Switch_G2/DT2_{12}: J6.14; also elsewhere on the board
/Switch_G2/DT2_{13}: J6.18; also elsewhere on the board
/Switch_G2/DT2_{14}: J6.22; also elsewhere on the board
/Switch_G2/DT2_{15}: J6.26; also elsewhere on the board
/Switch_G2/DT2_{16}: J6.30; also elsewhere on the board
/VOLTMETER_OUT_N: J6.4, J6.8, J6.12, J6.16, J6.20, J6.24, J6.28, J6.32; also elsewhere on the board
/VOLTMETER_OUT_P: J6.3, J6.7, J6.11, J6.15, J6.19, J6.23, J6.27, J6.31; also elsewhere on the board
Earth: J6.0 (PAD); also elsewhere on the board

Notes on the sheet:
Обозначение выводов ДТ-500М Номер вывода Цветовая маркировка Функциональное назначение 1 Красный Напряжение питания 27 В 2 Белый Общий 3 Желтый Аналоговый выход (+) 4 Синий Аналоговый выход (-)
Группа #2 ДТ #9...16

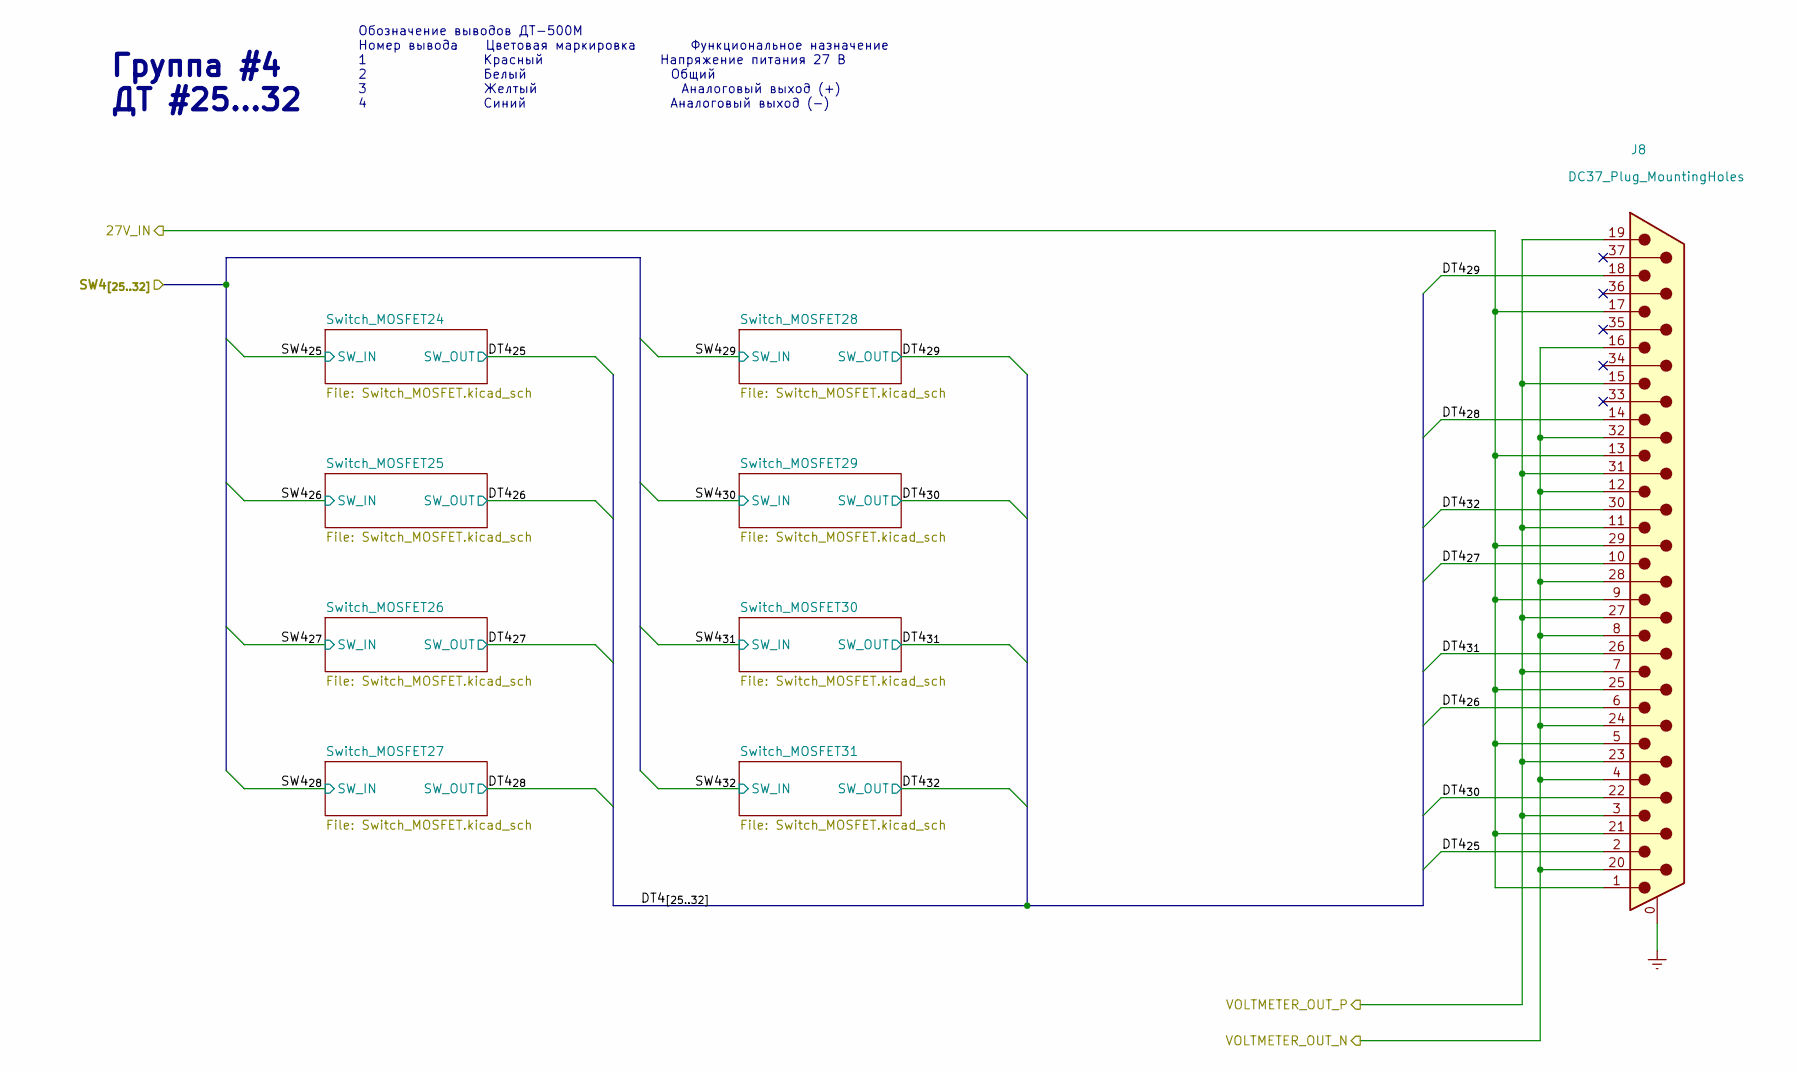
[picture p17: schematic Switch_G4.kicad_sch]

Parts:
J8: DC37_Plug_MountingHoles; DSUB-37_Male_Vertical_P2.77x2.84mm_MountingHoles

Connections:
/Switch_G1/27V_IN: J8.1, J8.5, J8.9, J8.13, J8.17, J8.21, J8.25, J8.29; also elsewhere on the board
/Switch_G4/DT4_{25}: J8.2; also elsewhere on the board
/Switch_G4/DT4_{26}: J8.6; also elsewhere on the board
/Switch_G4/DT4_{27}: J8.10; also elsewhere on the board
/Switch_G4/DT4_{28}: J8.14; also elsewhere on the board
/Switch_G4/DT4_{29}: J8.18; also elsewhere on the board
/Switch_G4/DT4_{30}: J8.22; also elsewhere on the board
/Switch_G4/DT4_{31}: J8.26; also elsewhere on the board
/Switch_G4/DT4_{32}: J8.30; also elsewhere on the board
/VOLTMETER_OUT_N: J8.4, J8.8, J8.12, J8.16, J8.20, J8.24, J8.28, J8.32; also elsewhere on the board
/VOLTMETER_OUT_P: J8.3, J8.7, J8.11, J8.15, J8.19, J8.23, J8.27, J8.31; also elsewhere on the board
Earth: J8.0 (PAD); also elsewhere on the board

Notes on the sheet:
Группа #4 ДТ #25...32
Обозначение выводов ДТ-500М Номер вывода Цветовая маркировка Функциональное назначение 1 Красный Напряжение питания 27 В 2 Белый Общий 3 Желтый Аналоговый выход (+) 4 Синий Аналоговый выход (-)

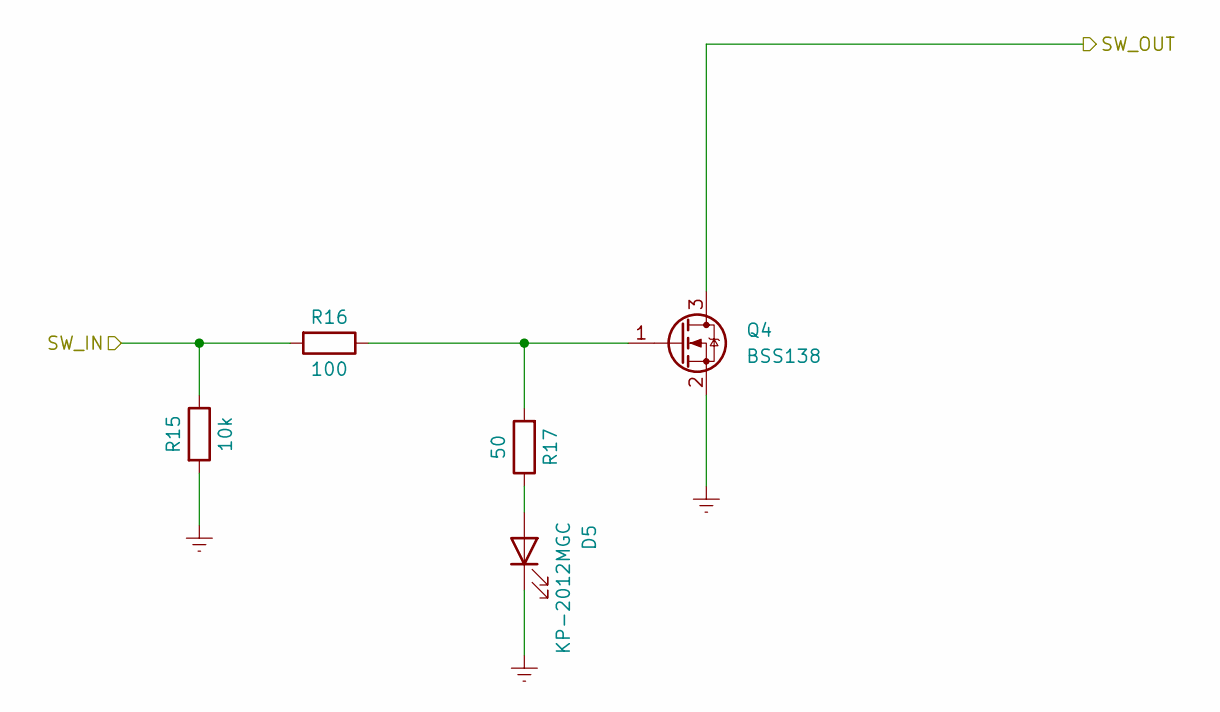
[picture p18: schematic Switch_MOSFET.kicad_sch]

Parts:
D5: KP-2012MGC; LED_0805_2012Metric_Pad1.15x1.40mm_HandSolder
Q4: BSS138; SOT-23
R15: 10k; R_1206_3216Metric_Pad1.30x1.75mm_HandSolder
R16: 100; R_1206_3216Metric_Pad1.30x1.75mm_HandSolder
R17: 50; R_1206_3216Metric_Pad1.30x1.75mm_HandSolder

Connections:
/MCU/SW1_{1}: R15.1, R16.2; also elsewhere on the board
/Switch_G1/DT1_{1}: Q4.3 (D); also elsewhere on the board
Earth: D5.1 (K), Q4.2 (S), R15.2; also elsewhere on the board
unnamed: D5.2 (A), R17.1
unnamed: Q4.1 (G), R16.1, R17.2

Parts of its further copies:
D2, D3, D4, D6, D7, D8, D9, D10, D11, D12, D13, D14, D15, D16, D17, D18, D19, D20, D21, D22, D23, D24, D25, D26, D27, D28, D29, D30, D31, D32, D33: KP-2012MGC; LED_0805_2012Metric_Pad1.15x1.40mm_HandSolder
Q1, Q2, Q3, Q5, Q6, Q7, Q8, Q9, Q10, Q11, Q12, Q13, Q14, Q15, Q16, Q17, Q18, Q19, Q20, Q21, Q22, Q23, Q24, Q25, Q26, Q27, Q28, Q29, Q30, Q31, Q32: BSS138; SOT-23
R2, R9, R12, R18, R21, R24, R27, R30, R33, R36, R39, R42, R45, R48, R51, R54, R57, R60, R63, R66, R69, R72, R75, R78, R81, R84, R87, R90, R93, R96, R99: 10k; R_1206_3216Metric_Pad1.30x1.75mm_HandSolder
R3, R10, R13, R19, R22, R25, R28, R31, R34, R37, R40, R43, R46, R49, R52, R55, R58, R61, R64, R67, R70, R73, R76, R79, R82, R85, R88, R91, R94, R97, R100: 100; R_1206_3216Metric_Pad1.30x1.75mm_HandSolder
R4, R11, R14, R20, R23, R26, R29, R32, R35, R38, R41, R44, R47, R50, R53, R56, R59, R62, R65, R68, R71, R74, R77, R80, R83, R86, R89, R92, R95, R98, R101: 50; R_1206_3216Metric_Pad1.30x1.75mm_HandSolder

Connections of its further copies:
/MCU/SW1_{2}: R18.1, R19.2; also elsewhere on the board
/MCU/SW1_{3}: R21.1, R22.2; also elsewhere on the board
/MCU/SW1_{4}: R12.1, R13.2; also elsewhere on the board
/MCU/SW1_{5}: R24.1, R25.2; also elsewhere on the board
/MCU/SW1_{6}: R30.1, R31.2; also elsewhere on the board
/MCU/SW1_{7}: R33.1, R34.2; also elsewhere on the board
/MCU/SW1_{8}: R27.1, R28.2; also elsewhere on the board
/MCU/SW2_{9}: R36.1, R37.2; also elsewhere on the board
/MCU/SW2_{10}: R39.1, R40.2; also elsewhere on the board
/MCU/SW2_{11}: R54.1, R55.2; also elsewhere on the board
/MCU/SW2_{12}: R42.1, R43.2; also elsewhere on the board
/MCU/SW2_{13}: R51.1, R52.2; also elsewhere on the board
/MCU/SW2_{14}: R48.1, R49.2; also elsewhere on the board
/MCU/SW2_{15}: R45.1, R46.2; also elsewhere on the board
/MCU/SW2_{16}: R9.1, R10.2; also elsewhere on the board
/MCU/SW3_{17}: R57.1, R58.2; also elsewhere on the board
/MCU/SW3_{18}: R60.1, R61.2; also elsewhere on the board
/MCU/SW3_{19}: R69.1, R70.2; also elsewhere on the board
/MCU/SW3_{20}: R75.1, R76.2; also elsewhere on the board
/MCU/SW3_{21}: R78.1, R79.2; also elsewhere on the board
/MCU/SW3_{22}: R63.1, R64.2; also elsewhere on the board
/MCU/SW3_{23}: R66.1, R67.2; also elsewhere on the board
/MCU/SW3_{24}: R72.1, R73.2; also elsewhere on the board
/MCU/SW4_{25}: R2.1, R3.2; also elsewhere on the board
/MCU/SW4_{26}: R90.1, R91.2; also elsewhere on the board
/MCU/SW4_{27}: R87.1, R88.2; also elsewhere on the board
/MCU/SW4_{28}: R99.1, R100.2; also elsewhere on the board
/MCU/SW4_{29}: R96.1, R97.2; also elsewhere on the board
/MCU/SW4_{30}: R84.1, R85.2; also elsewhere on the board
/MCU/SW4_{31}: R81.1, R82.2; also elsewhere on the board
/MCU/SW4_{32}: R93.1, R94.2; also elsewhere on the board
/Switch_G1/DT1_{2}: Q5.3 (D); also elsewhere on the board
/Switch_G1/DT1_{3}: Q6.3 (D); also elsewhere on the board
/Switch_G1/DT1_{4}: Q3.3 (D); also elsewhere on the board
/Switch_G1/DT1_{5}: Q7.3 (D); also elsewhere on the board
/Switch_G1/DT1_{6}: Q9.3 (D); also elsewhere on the board
/Switch_G1/DT1_{7}: Q10.3 (D); also elsewhere on the board
/Switch_G1/DT1_{8}: Q8.3 (D); also elsewhere on the board
/Switch_G2/DT2_{9}: Q11.3 (D); also elsewhere on the board
/Switch_G2/DT2_{10}: Q12.3 (D); also elsewhere on the board
/Switch_G2/DT2_{11}: Q17.3 (D); also elsewhere on the board
/Switch_G2/DT2_{12}: Q13.3 (D); also elsewhere on the board
/Switch_G2/DT2_{13}: Q16.3 (D); also elsewhere on the board
/Switch_G2/DT2_{14}: Q15.3 (D); also elsewhere on the board
/Switch_G2/DT2_{15}: Q14.3 (D); also elsewhere on the board
/Switch_G2/DT2_{16}: Q2.3 (D); also elsewhere on the board
/Switch_G3/DT3_{17}: Q18.3 (D); also elsewhere on the board
/Switch_G3/DT3_{18}: Q19.3 (D); also elsewhere on the board
/Switch_G3/DT3_{19}: Q22.3 (D); also elsewhere on the board
/Switch_G3/DT3_{20}: Q24.3 (D); also elsewhere on the board
/Switch_G3/DT3_{21}: Q25.3 (D); also elsewhere on the board
/Switch_G3/DT3_{22}: Q20.3 (D); also elsewhere on the board
/Switch_G3/DT3_{23}: Q21.3 (D); also elsewhere on the board
/Switch_G3/DT3_{24}: Q23.3 (D); also elsewhere on the board
/Switch_G4/DT4_{25}: Q1.3 (D); also elsewhere on the board
/Switch_G4/DT4_{26}: Q29.3 (D); also elsewhere on the board
/Switch_G4/DT4_{27}: Q28.3 (D); also elsewhere on the board
/Switch_G4/DT4_{28}: Q32.3 (D); also elsewhere on the board
/Switch_G4/DT4_{29}: Q31.3 (D); also elsewhere on the board
/Switch_G4/DT4_{30}: Q27.3 (D); also elsewhere on the board
/Switch_G4/DT4_{31}: Q26.3 (D); also elsewhere on the board
/Switch_G4/DT4_{32}: Q30.3 (D); also elsewhere on the board
Earth: D2.1 (K), D3.1 (K), D4.1 (K), D6.1 (K), D7.1 (K), D8.1 (K), D9.1 (K), D10.1 (K), D11.1 (K), D12.1 (K), D13.1 (K), D14.1 (K), D15.1 (K), D16.1 (K), D17.1 (K), D18.1 (K), D19.1 (K), D20.1 (K), D21.1 (K), D22.1 (K), D23.1 (K), D24.1 (K), D25.1 (K), D26.1 (K), D27.1 (K), D28.1 (K), D29.1 (K), D30.1 (K), D31.1 (K), D32.1 (K), D33.1 (K), Q1.2 (S), Q2.2 (S), Q3.2 (S), Q5.2 (S), Q6.2 (S), Q7.2 (S), Q8.2 (S), Q9.2 (S), Q10.2 (S), Q11.2 (S), Q12.2 (S), Q13.2 (S), Q14.2 (S), Q15.2 (S), Q16.2 (S), Q17.2 (S), Q18.2 (S), Q19.2 (S), Q20.2 (S), Q21.2 (S), Q22.2 (S), Q23.2 (S), Q24.2 (S), Q25.2 (S), Q26.2 (S), Q27.2 (S), Q28.2 (S), Q29.2 (S), Q30.2 (S), Q31.2 (S), Q32.2 (S), R2.2, R9.2, R12.2, R18.2, R21.2, R24.2, R27.2, R30.2, R33.2, R36.2, R39.2, R42.2, R45.2, R48.2, R51.2, R54.2, R57.2, R60.2, R63.2, R66.2, R69.2, R72.2, R75.2, R78.2, R81.2, R84.2, R87.2, R90.2, R93.2, R96.2, R99.2; also elsewhere on the board
unnamed: D2.2 (A), R4.1
unnamed: D3.2 (A), R11.1
unnamed: D4.2 (A), R14.1
unnamed: D6.2 (A), R20.1
unnamed: D7.2 (A), R23.1
unnamed: D8.2 (A), R26.1
unnamed: D9.2 (A), R29.1
unnamed: D10.2 (A), R32.1
unnamed: D11.2 (A), R35.1
unnamed: D12.2 (A), R38.1
unnamed: D13.2 (A), R41.1
unnamed: D14.2 (A), R44.1
unnamed: D15.2 (A), R47.1
unnamed: D16.2 (A), R50.1
unnamed: D17.2 (A), R53.1
unnamed: D18.2 (A), R56.1
unnamed: D19.2 (A), R59.1
unnamed: D20.2 (A), R62.1
unnamed: D21.2 (A), R65.1
unnamed: D22.2 (A), R68.1
unnamed: D23.2 (A), R71.1
unnamed: D24.2 (A), R74.1
unnamed: D25.2 (A), R77.1
unnamed: D26.2 (A), R80.1
unnamed: D27.2 (A), R83.1
unnamed: D28.2 (A), R86.1
unnamed: D29.2 (A), R89.1
unnamed: D30.2 (A), R92.1
unnamed: D31.2 (A), R95.1
unnamed: D32.2 (A), R98.1
unnamed: D33.2 (A), R101.1
unnamed: Q1.1 (G), R3.1, R4.2
unnamed: Q2.1 (G), R10.1, R11.2
unnamed: Q3.1 (G), R13.1, R14.2
unnamed: Q5.1 (G), R19.1, R20.2
unnamed: Q6.1 (G), R22.1, R23.2
unnamed: Q7.1 (G), R25.1, R26.2
unnamed: Q8.1 (G), R28.1, R29.2
unnamed: Q9.1 (G), R31.1, R32.2
unnamed: Q10.1 (G), R34.1, R35.2
unnamed: Q11.1 (G), R37.1, R38.2
unnamed: Q12.1 (G), R40.1, R41.2
unnamed: Q13.1 (G), R43.1, R44.2
unnamed: Q14.1 (G), R46.1, R47.2
unnamed: Q15.1 (G), R49.1, R50.2
unnamed: Q16.1 (G), R52.1, R53.2
unnamed: Q17.1 (G), R55.1, R56.2
unnamed: Q18.1 (G), R58.1, R59.2
unnamed: Q19.1 (G), R61.1, R62.2
unnamed: Q20.1 (G), R64.1, R65.2
unnamed: Q21.1 (G), R67.1, R68.2
unnamed: Q22.1 (G), R70.1, R71.2
unnamed: Q23.1 (G), R73.1, R74.2
unnamed: Q24.1 (G), R76.1, R77.2
unnamed: Q25.1 (G), R79.1, R80.2
unnamed: Q26.1 (G), R82.1, R83.2
unnamed: Q27.1 (G), R85.1, R86.2
unnamed: Q28.1 (G), R88.1, R89.2
unnamed: Q29.1 (G), R91.1, R92.2
unnamed: Q30.1 (G), R94.1, R95.2
unnamed: Q31.1 (G), R97.1, R98.2
unnamed: Q32.1 (G), R100.1, R101.2
