SkyEngineer/sensor_current_stand/3 Elektronik/sensor_current_stand/sensor_current_stand/sensor_current_stand.kicad_pcb

## KiCad design 3 Elektronik/sensor_current_stand/sensor_current_stand/sensor_current_stand.kicad_pcb (continued)

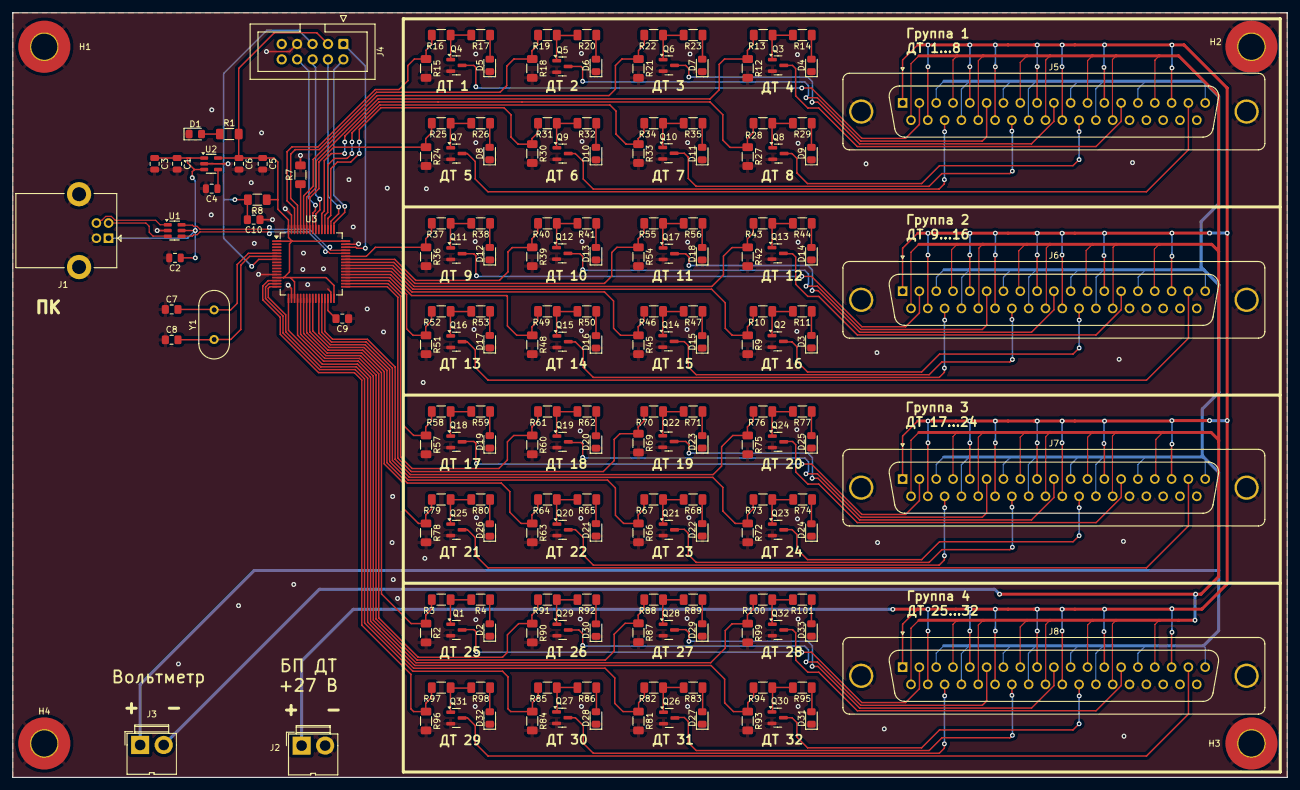
[picture p19: board sensor_current_stand.kicad_pcb from above]

Board: 2 copper layers, 210.0 x 126.0 mm, 190 parts (0 on the bottom side), 150 nets.
