SkyEngineer/sensor_current_stand/5_Soft/1. Embedded_SW/stand_DT/Core/Src/main.c

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
/* Includes ------------------------------------------------------------------*/
#include "main.h"
#include "usb_device.h"
#include "gpio.h"

/* USER CODE BEGIN Includes */
#include "usbd_cdc_if.h"
/* USER CODE END Includes */


/* USER CODE BEGIN PV */
// ответ на запрос
uint8_t ID[2]={0xBB, 0x0A};

// ответ на команду включения, что мы не зависли и отвечаем
uint8_t ANTWORT[2]={0xEE, 0x0A};
uint8_t ANTWORT_DT[2]={0xCC, 0x0A};

// входной буфер
uint8_t RxData[1] = {0};

// масссив для формирования выхода
uint32_t out_state[32] = {0};

//struct point center = {0};
//union code n;
void Reset_all_outs(void);
/* USER CODE END PV */

void SystemClock_Config(void);
/* USER CODE BEGIN 0 */
// отключение адресных выходов для всех мультиплексоров
void Reset_all_outs(void)
{
	HAL_GPIO_WritePin(SW1_1_GPIO_Port, SW1_1_Pin, GPIO_PIN_RESET);
	HAL_GPIO_WritePin(SW1_2_GPIO_Port, SW1_2_Pin, GPIO_PIN_RESET);
	HAL_GPIO_WritePin(SW1_3_GPIO_Port, SW1_3_Pin, GPIO_PIN_RESET);
	HAL_GPIO_WritePin(SW1_4_GPIO_Port, SW1_4_Pin, GPIO_PIN_RESET);
	HAL_GPIO_WritePin(SW1_5_GPIO_Port, SW1_5_Pin, GPIO_PIN_RESET);
	HAL_GPIO_WritePin(SW1_6_GPIO_Port, SW1_6_Pin, GPIO_PIN_RESET);
	HAL_GPIO_WritePin(SW1_7_GPIO_Port, SW1_7_Pin, GPIO_PIN_RESET);
	HAL_GPIO_WritePin(SW1_8_GPIO_Port, SW1_8_Pin, GPIO_PIN_RESET);
	HAL_GPIO_WritePin(SW2_9_GPIO_Port, SW2_9_Pin, GPIO_PIN_RESET);
	HAL_GPIO_WritePin(SW2_10_GPIO_Port, SW2_10_Pin, GPIO_PIN_RESET);
	HAL_GPIO_WritePin(SW2_11_GPIO_Port, SW2_11_Pin, GPIO_PIN_RESET);
	HAL_GPIO_WritePin(SW2_12_GPIO_Port, SW2_12_Pin, GPIO_PIN_RESET);
	HAL_GPIO_WritePin(SW2_13_GPIO_Port, SW2_13_Pin, GPIO_PIN_RESET);
	HAL_GPIO_WritePin(SW2_14_GPIO_Port, SW2_14_Pin, GPIO_PIN_RESET);
	HAL_GPIO_WritePin(SW2_15_GPIO_Port, SW2_15_Pin, GPIO_PIN_RESET);
	HAL_GPIO_WritePin(SW2_16_GPIO_Port, SW2_16_Pin, GPIO_PIN_RESET);
	HAL_GPIO_WritePin(SW3_17_GPIO_Port, SW3_17_Pin, GPIO_PIN_RESET);
	HAL_GPIO_WritePin(SW3_18_GPIO_Port, SW3_18_Pin, GPIO_PIN_RESET);
	HAL_GPIO_WritePin(SW3_19_GPIO_Port, SW3_19_Pin, GPIO_PIN_RESET);
	HAL_GPIO_WritePin(SW3_20_GPIO_Port, SW3_20_Pin, GPIO_PIN_RESET);
	HAL_GPIO_WritePin(SW3_21_GPIO_Port, SW3_21_Pin, GPIO_PIN_RESET);
	HAL_GPIO_WritePin(SW3_22_GPIO_Port, SW3_22_Pin, GPIO_PIN_RESET);
	HAL_GPIO_WritePin(SW3_23_GPIO_Port, SW3_23_Pin, GPIO_PIN_RESET);
	HAL_GPIO_WritePin(SW3_24_GPIO_Port, SW3_24_Pin, GPIO_PIN_RESET);
	HAL_GPIO_WritePin(SW4_25_GPIO_Port, SW4_25_Pin, GPIO_PIN_RESET);
	HAL_GPIO_WritePin(SW4_26_GPIO_Port, SW4_26_Pin, GPIO_PIN_RESET);
	HAL_GPIO_WritePin(SW4_27_GPIO_Port, SW4_27_Pin, GPIO_PIN_RESET);
	HAL_GPIO_WritePin(SW4_28_GPIO_Port, SW4_28_Pin, GPIO_PIN_RESET);
	HAL_GPIO_WritePin(SW4_29_GPIO_Port, SW4_29_Pin, GPIO_PIN_RESET);
	HAL_GPIO_WritePin(SW4_30_GPIO_Port, SW4_30_Pin, GPIO_PIN_RESET);
	HAL_GPIO_WritePin(SW4_31_GPIO_Port, SW4_31_Pin, GPIO_PIN_RESET);
	HAL_GPIO_WritePin(SW4_32_GPIO_Port, SW4_32_Pin, GPIO_PIN_RESET);

	HAL_Delay(100);
};

/* USER CODE END 0 */

/**
  * @brief  The application entry point.
  * @retval int
  */
int main(void)
{
  /* MCU Configuration--------------------------------------------------------*/

  /* Reset of all peripherals, Initializes the Flash interface and the Systick. */
  HAL_Init();

  /* Configure the system clock */
  SystemClock_Config();

  /* Initialize all configured peripherals */
  MX_GPIO_Init();
  MX_USB_DEVICE_Init();
  /* USER CODE BEGIN 2 */
  Reset_all_outs();
  /* USER CODE END 2 */

  /* Infinite loop */
  /* USER CODE BEGIN WHILE */
  while (1)
  {
    /* USER CODE END WHILE */

    /* USER CODE BEGIN 3 */

  	  //обработка запроса
  	  CDC_Receive_FS(RxData, 1);

	  switch(RxData[0])
	  {
		  case 1:
			  Reset_all_outs();
	  			HAL_GPIO_WritePin(SW1_1_GPIO_Port, SW1_1_Pin, GPIO_PIN_SET);
	  			CDC_Transmit_FS(ANTWORT_DT, 2);
	  			RxData[0] = 0x00;
			break;
		  case 2:
			  Reset_all_outs();
	  			HAL_GPIO_WritePin(SW1_2_GPIO_Port, SW1_2_Pin, GPIO_PIN_SET);
	  			CDC_Transmit_FS(ANTWORT_DT, 2);
	  			RxData[0] = 0x00;
			break;
		  case 3:
			  Reset_all_outs();
	  			HAL_GPIO_WritePin(SW1_3_GPIO_Port, SW1_3_Pin, GPIO_PIN_SET);
	  			CDC_Transmit_FS(ANTWORT_DT, 2);
	  			RxData[0] = 0x00;
			break;
		  case 4:
			  Reset_all_outs();
	  			HAL_GPIO_WritePin(SW1_4_GPIO_Port, SW1_4_Pin, GPIO_PIN_SET);
	  			CDC_Transmit_FS(ANTWORT_DT, 2);
	  			RxData[0] = 0x00;
			break;
		  case 5:
			  Reset_all_outs();
	  			HAL_GPIO_WritePin(SW1_5_GPIO_Port, SW1_5_Pin, GPIO_PIN_SET);
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
	  			CDC_Transmit_FS(ANTWORT_DT, 2);
	  			RxData[0] = 0x00;
			break;
		  case 30:
			  Reset_all_outs();
	  			HAL_GPIO_WritePin(SW4_30_GPIO_Port, SW4_30_Pin, GPIO_PIN_SET);
	  			CDC_Transmit_FS(ANTWORT_DT, 2);
	  			RxData[0] = 0x00;
			break;
		  case 31:
			  Reset_all_outs();
	  			HAL_GPIO_WritePin(SW4_31_GPIO_Port, SW4_31_Pin, GPIO_PIN_SET);
	  			CDC_Transmit_FS(ANTWORT_DT, 2);
	  			RxData[0] = 0x00;
			break;
		  case 32:
			  Reset_all_outs();
	  			HAL_GPIO_WritePin(SW4_32_GPIO_Port, SW4_32_Pin, GPIO_PIN_SET);
	  			CDC_Transmit_FS(ANTWORT_DT, 2);
	  			RxData[0] = 0x00;
			break;

		case 170: //запрос опознания, отвечаем на это 0xBB
			CDC_Transmit_FS(ID, 2);
			RxData[0] = 0x00;
			break;
		case 0xFF: //команда полной остановки
			Reset_all_outs();
			CDC_Transmit_FS(ANTWORT, 2);
			RxData[0] = 0x00;
			break;
		default:
			;
			break;
	  }
  	  HAL_Delay(10);

  /*

  HAL_Delay(100);
  HAL_GPIO_TogglePin(E_U_MUX_GPIO_Port, E_U_MUX_Pin);
  CDC_Receive_FS(RxData,  (uint32_t)1);
  CDC_Transmit_FS(ANTWORT, 1);*/

  }
  /* USER CODE END 3 */
}

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
