SkyEngineer/sensor_current_stand/5_Soft/1. Embedded_SW/0. Beispielen/USB/source/hw_config.c

/**
  ******************************************************************************
  * @file    hw_config.c
  * @author  MCD Application Team
  * @version V4.0.0
  * @date    21-January-2013
  * @brief   Hardware Configuration & Setup
  ******************************************************************************
  * @attention
  *
  * <h2><center>&copy; COPYRIGHT 2013 STMicroelectronics</center></h2>
  *
  * Licensed under MCD-ST Liberty SW License Agreement V2, (the "License");
  * You may not use this file except in compliance with the License.
  * You may obtain a copy of the License at:
  *
  *        http://www.st.com/software_license_agreement_liberty_v2
  *
  * Unless required by applicable law or agreed to in writing, software 
  * distributed under the License is distributed on an "AS IS" BASIS, 
  * WITHOUT WARRANTIES OR CONDITIONS OF ANY KIND, either express or implied.
  * See the License for the specific language governing permissions and
  * limitations under the License.
  *
  ******************************************************************************
  */


/* Includes ------------------------------------------------------------------*/

#include "stm32_it.h"
#include "usb_lib.h"
#include "usb_prop.h"
#include "usb_desc.h"
#include "hw_config.h"
#include "usb_pwr.h"


/* Private typedef -----------------------------------------------------------*/
/* Private define ------------------------------------------------------------*/
/* Private macro -------------------------------------------------------------*/
/* Private variables ---------------------------------------------------------*/
ErrorStatus HSEStartUpStatus;
USART_InitTypeDef USART_InitStructure;
EXTI_InitTypeDef EXTI_InitStructure;
uint8_t  USART_Rx_Buffer [USART_RX_DATA_SIZE]; 
uint32_t USART_Rx_ptr_in = 0;
uint32_t USART_Rx_ptr_out = 0;
uint32_t USART_Rx_length  = 0;

uint8_t  USB_Tx_State = 0;
static void IntToUnicode (uint32_t value , uint8_t *pbuf , uint8_t len);
/* Extern variables ----------------------------------------------------------*/

extern LINE_CODING linecoding;

/* Private function prototypes -----------------------------------------------*/
/* Private functions ---------------------------------------------------------*/
/*******************************************************************************
* Function Name  : Set_System
* Description    : Configures Main system clocks & power
* Input          : None.
* Return         : None.
*******************************************************************************/
void Set_System(void)
{
  GPIO_InitTypeDef GPIO_InitStructure;

  RCC_APB2PeriphClockCmd(RCC_APB2Periph_SYSCFG, ENABLE);
 
  RCC_AHBPeriphClockCmd(RCC_AHBPeriph_GPIOA, ENABLE);
	RCC_AHBPeriphClockCmd(RCC_AHBPeriph_GPIOE, ENABLE);
	
  GPIO_InitStructure.GPIO_Pin = GPIO_Pin_11 | GPIO_Pin_12;
  GPIO_InitStructure.GPIO_Speed = GPIO_Speed_50MHz;
  GPIO_InitStructure.GPIO_Mode = GPIO_Mode_AF;
  GPIO_InitStructure.GPIO_OType = GPIO_OType_PP;
  GPIO_InitStructure.GPIO_PuPd = GPIO_PuPd_NOPULL;
  GPIO_Init(GPIOA, &GPIO_InitStructure);
	
	GPIO_InitStructure.GPIO_Pin = GPIO_Pin_9 | GPIO_Pin_8 | GPIO_Pin_10 |  GPIO_Pin_15 | GPIO_Pin_11 | GPIO_Pin_14 | GPIO_Pin_12 | GPIO_Pin_13;
  GPIO_InitStructure.GPIO_Speed = GPIO_Speed_50MHz;
  GPIO_InitStructure.GPIO_Mode = GPIO_Mode_OUT;
  GPIO_Init(GPIOE, &GPIO_InitStructure);
  
  GPIO_PinAFConfig(GPIOA, GPIO_PinSource11, GPIO_AF_14);
  GPIO_PinAFConfig(GPIOA, GPIO_PinSource12, GPIO_AF_14);

  EXTI_ClearITPendingBit(EXTI_Line18);
  EXTI_InitStructure.EXTI_Line = EXTI_Line18; 
  EXTI_InitStructure.EXTI_Trigger = EXTI_Trigger_Rising;
  EXTI_InitStructure.EXTI_LineCmd = ENABLE;
  EXTI_Init(&EXTI_InitStructure);
}

/*******************************************************************************
* Function Name  : Set_USBClock
* Description    : Configures USB Clock input (48MHz)
* Input          : None.
* Return         : None.
*******************************************************************************/
void Set_USBClock(void)
{
  RCC_USBCLKConfig(RCC_USBCLKSource_PLLCLK_1Div5);

  RCC_APB1PeriphClockCmd(RCC_APB1Periph_USB, ENABLE);
}

/*******************************************************************************
* Function Name  : Enter_LowPowerMode
* Description    : Power-off system clocks and power while entering suspend mode
* Input          : None.
* Return         : None.
*******************************************************************************/
void Enter_LowPowerMode(void)
{
  /* Set the device state to suspend */
  bDeviceState = SUSPENDED;
}

/*******************************************************************************
* Function Name  : Leave_LowPowerMode
* Description    : Restores system clocks and power while exiting suspend mode
* Input          : None.
* Return         : None.
*******************************************************************************/
void Leave_LowPowerMode(void)
{
  DEVICE_INFO *pInfo = &Device_Info;

  /* Set the device state to the correct state */
  if (pInfo->Current_Configuration != 0)
  {
    /* Device configured */
    bDeviceState = CONFIGURED;
  }
  else
  {
    bDeviceState = ATTACHED;
  }
  /*Enable SystemCoreClock*/
  SystemInit();
}

/*******************************************************************************
* Function Name  : USB_Interrupts_Config
* Description    : Configures the USB interrupts
* Input          : None.
* Return         : None.
*******************************************************************************/
void USB_Interrupts_Config(void)
{
  NVIC_InitTypeDef NVIC_InitStructure; 
  
  NVIC_PriorityGroupConfig(NVIC_PriorityGroup_2);  
  
  NVIC_InitStructure.NVIC_IRQChannel = USB_LP_CAN1_RX0_IRQn;
  NVIC_InitStructure.NVIC_IRQChannelPreemptionPriority = 2;
  NVIC_InitStructure.NVIC_IRQChannelSubPriority = 0;
  NVIC_InitStructure.NVIC_IRQChannelCmd = ENABLE;
  NVIC_Init(&NVIC_InitStructure);
  
  NVIC_InitStructure.NVIC_IRQChannel = USBWakeUp_IRQn;
  NVIC_InitStructure.NVIC_IRQChannelPreemptionPriority = 0;
  NVIC_Init(&NVIC_InitStructure);
}

/*******************************************************************************
* Function Name  : USB_Cable_Config
* Description    : Software Connection/Disconnection of USB Cable
* Input          : None.
* Return         : Status
*******************************************************************************/
void USB_Cable_Config (FunctionalState NewState)
{
}

/*******************************************************************************
* Function Name  :  USART_Config_Default.
* Description    :  configure the EVAL_COM1 with default values.
* Input          :  None.
* Return         :  None.
*******************************************************************************/
void USART_Config_Default(void)
{
}

/*******************************************************************************
* Function Name  :  USART_Config.
* Description    :  Configure the EVAL_COM1 according to the line coding structure.
* Input          :  None.
* Return         :  Configuration status
                    TRUE : configuration done with success
                    FALSE : configuration aborted.
*******************************************************************************/
bool USART_Config(void)
{
	return 0;
}

/*******************************************************************************
* Function Name  : USB_To_USART_Send_Data.
* Description    : send the received data from USB to the UART 0.
* Input          : data_buffer: data address.
                   Nb_bytes: number of bytes to send.
* Return         : none.
*******************************************************************************/
void USB_To_USART_Send_Data(uint8_t* data_buffer, uint8_t Nb_bytes)
{ 
}

/*******************************************************************************
* Function Name  : Handle_USBAsynchXfer.
* Description    : send data to USB.
* Input          : None.
* Return         : none.
*******************************************************************************/
void Handle_USBAsynchXfer (void)
{
  
  uint16_t USB_Tx_ptr;
  uint16_t USB_Tx_length;
  
  if(USB_Tx_State != 1)
  {
    if (USART_Rx_ptr_out == USART_RX_DATA_SIZE)
    {
      USART_Rx_ptr_out = 0;
    }
    
    if(USART_Rx_ptr_out == USART_Rx_ptr_in) 
    {
      USB_Tx_State = 0; 
      return;
    }
    
    if(USART_Rx_ptr_out > USART_Rx_ptr_in) /* rollback */
    { 
      USART_Rx_length = USART_RX_DATA_SIZE - USART_Rx_ptr_out;
    }
    else 
    {
      USART_Rx_length = USART_Rx_ptr_in - USART_Rx_ptr_out;
    }
    
    if (USART_Rx_length > VIRTUAL_COM_PORT_DATA_SIZE)
    {
      USB_Tx_ptr = USART_Rx_ptr_out;
      USB_Tx_length = VIRTUAL_COM_PORT_DATA_SIZE;
      
      USART_Rx_ptr_out += VIRTUAL_COM_PORT_DATA_SIZE;	
      USART_Rx_length -= VIRTUAL_COM_PORT_DATA_SIZE;	
    }
    else
    {
      USB_Tx_ptr = USART_Rx_ptr_out;
      USB_Tx_length = USART_Rx_length;
      
      USART_Rx_ptr_out += USART_Rx_length;
      USART_Rx_length = 0;
    }
    USB_Tx_State = 1; 
    UserToPMABufferCopy(&USART_Rx_Buffer[USB_Tx_ptr], ENDP1_TXADDR, USB_Tx_length);
    SetEPTxCount(ENDP1, USB_Tx_length);
    SetEPTxValid(ENDP1); 
  }  
  
}
/*******************************************************************************
* Function Name  : UART_To_USB_Send_Data.
* Description    : send the received data from UART 0 to USB.
* Input          : None.
* Return         : none.
*******************************************************************************/
void USART_To_USB_Send_Data(void)
{
}

/*******************************************************************************
* Function Name  : Get_SerialNum.
* Description    : Create the serial number string descriptor.
* Input          : None.
* Output         : None.
* Return         : None.
*******************************************************************************/
void Get_SerialNum(void)
{
  uint32_t Device_Serial0, Device_Serial1, Device_Serial2;

  Device_Serial0 = *(uint32_t*)ID1;
  Device_Serial1 = *(uint32_t*)ID2;
  Device_Serial2 = *(uint32_t*)ID3;  

  Device_Serial0 += Device_Serial2;

  if (Device_Serial0 != 0)
  {
    IntToUnicode (Device_Serial0, &Virtual_Com_Port_StringSerial[2] , 8);
    IntToUnicode (Device_Serial1, &Virtual_Com_Port_StringSerial[18], 4);
  }
}

/*******************************************************************************
* Function Name  : HexToChar.
* Description    : Convert Hex 32Bits value into char.
* Input          : None.
* Output         : None.
* Return         : None.
*******************************************************************************/
static void IntToUnicode (uint32_t value , uint8_t *pbuf , uint8_t len)
{
  uint8_t idx = 0;
  
  for( idx = 0 ; idx < len ; idx ++)
  {
    if( ((value >> 28)) < 0xA )
    {
      pbuf[ 2* idx] = (value >> 28) + '0';
    }
    else
    {
      pbuf[2* idx] = (value >> 28) + 'A' - 10; 
    }
    
    value = value << 4;
    
    pbuf[ 2* idx + 1] = 0;
  }
}

void GPIO_ResetLeds()
{
	GPIO_ResetBits(GPIOE, GPIO_Pin_8);
	GPIO_ResetBits(GPIOE, GPIO_Pin_9);
	GPIO_ResetBits(GPIOE, GPIO_Pin_10);
	GPIO_ResetBits(GPIOE, GPIO_Pin_11);
	GPIO_ResetBits(GPIOE, GPIO_Pin_12);
	GPIO_ResetBits(GPIOE, GPIO_Pin_13);
	GPIO_ResetBits(GPIOE, GPIO_Pin_14);
	GPIO_ResetBits(GPIOE, GPIO_Pin_15);
}

/************************ (C) COPYRIGHT STMicroelectronics *****END OF FILE****/
