SkyEngineer/sensor_current_stand/5_Soft/2_Desktop_SW/DT_500_Autotest v2/main.py

import com_ports
from PyQt6 import QtWidgets
import window_qt

if __name__ == '__main__':
    import sys
    # запуск приложения оконного
    app = QtWidgets.QApplication(sys.argv)
    window = window_qt.MyWindow()

    window.show()
    sys.exit(app.exec())
