SkyEngineer/sensor_current_stand/со стенда/DT_100_Autotest/voltmeter.py

class Voltmeter(object):
    '''Вольтметр АКИП-21011'''
    def __init__(self, com_port):
        self.port = com_port

    def set_com_port(self):
        '''устаналиваем порт'''
        pass

    def set_mdde(self):
        '''устаналиваем режим'''
        pass

    def get_data(self):
        '''получаем данные'''
        pass
