SkyEngineer/sensor_current_stand/(commit log)

2024-04-04 Размещение
2024-04-04 0 Vom Auftraggeber
    [Order_УПП.xls, Группа 1.SchDoc, Группа 2.SchDoc, Группа 3.SchDoc, Группа 4.SchDoc, ПЭ3-УПП.xls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]
2024-04-04 норм архитектура
2024-04-05 Update Архитектура стенда УПП.drawio
2024-04-10 разработка
    [Connectors_current_sensor.kicad_sch, MCU_Sheet.kicad_sch, MUX.kicad_sch, Switch.kicad_sch, secondary_supply.kicad_sch, sensor_current_stand.kicad_sch]
2024-04-10 архивы
2024-04-10 STM soft
    создание софта для общения с ПК на STM. Сейчас проект написан под STM32F3Discovery для отладки технических решений
2024-04-11 MUX sheet готово
    [MUX.kicad_sch]
2024-04-11 secondary supply готово
    [secondary_supply.kicad_sch]
2024-04-11 промежуточная версия
    надо правильно подключить прошивалку
    [MCU_Sheet.kicad_sch]
2024-04-17 Группа 1 разведена но не проверена
    [BOM.xlsx, Connectors_current_sensor.kicad_sch, MCU.kicad_sch, MUX.kicad_sch, Switch_G1.kicad_sch, Switch_G2.kicad_sch, Switch_G3.kicad_sch, Switch_G4.kicad_sch]
2024-04-19 трассировка
    [Switch_G4.kicad_sch, sensor_current_stand.kicad_pcb, sensor_current_stand.kicad_sch]
2024-04-19 переписка
2024-04-22 прверка на производстве
    [MCU.kicad_sch, MUX.kicad_sch, Switch_G1.kicad_sch, Switch_G2.kicad_sch, Switch_G3.kicad_sch, Switch_G4.kicad_sch, Switch_MOSFET.kicad_sch, secondary_supply.kicad_sch]
2024-04-23 счета
2024-04-24 окружение для тестового проекта STM_F4_DISC
2024-04-24 Kicad 8
    [MCU.kicad_sch, MUX.kicad_sch, Switch_G1.kicad_sch, Switch_G2.kicad_sch, Switch_G3.kicad_sch, Switch_G4.kicad_sch, Switch_MOSFET.kicad_sch, secondary_supply.kicad_sch]
2024-04-24 черновики договоров
2024-04-25 STM готов к отладке
2024-04-25 STM готово к отладке
2024-04-25 придирка к пробелам
2024-04-25 Create Ozon паяльная паста и приспособления.pdf
2024-05-09 Version 2
    [MCU.kicad_sch, Switch_G1.kicad_sch, Switch_G2.kicad_sch, Switch_G3.kicad_sch, Switch_G4.kicad_sch, Switch_MOSFET.kicad_sch, secondary_supply.kicad_sch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]
2024-05-10 v2 GEREBER
    [MCU.kicad_sch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]
2024-05-10 V2 GERBER
2024-05-27 подготовка к отладке
    [Template_report.xlsx]
2024-06-01 отладка
2024-06-03 отладка 2
    [New.xlsx, Template_report.xlsx, Протокол от 16_17 03.06.2024.xlsx, Протокол от 17_01 03.06.2024.xlsx]
2024-06-04 отработка
    не удается установить только общение нормально с БП измеряемого тока
    [Протокол от 19_25 03.06.2024.xlsx, Протокол от 19_40 03.06.2024.xlsx, Протокол от 19_44 03.06.2024.xlsx, Протокол от 19_49 03.06.2024.xlsx, Протокол от 19_54 03.06.2024.xlsx, Протокол от 20_01 03.06.2024.xlsx, Протокол от 20_03 03.06.2024.xlsx, Протокол от 20_11 03.06.2024.xlsx]
2024-06-17 ПО в МК
2024-06-30 проект завершён
    [New.xlsx, Template_report.xlsx, Протокол от 24.06.2024 в 13_52_07.xlsx, Протокол от 27.06.2024 в 19_14_00.xlsx, Протокол от 27.06.2024 в 19_21_29.xlsx]
2024-08-14 копиии
    [Template_report.xlsx, Протокол от 27.06.2024 в 19_14_00.xlsx, Протокол от 27.06.2024 в 19_21_29.xlsx, Протокол от 27.06.2024 в 19_40_05.xlsx, Протокол от 27.06.2024 в 19_42_56.xlsx, Протокол от 27.06.2024 в 19_48_14.xlsx, Протокол от 27.06.2024 в 19_51_49.xlsx]
