SkyEngineer/sensor_current_stand/(notices)

Notices in the files:
5_Soft/1. Embedded_SW/stand_DT/Core/Inc/main.h:
Copyright (c) 2024 STMicroelectronics.
All rights reserved.
This software is licensed under terms that can be found in the LICENSE file
