SkyEngineer/sensor_current_stand/3 Elektronik/sensor_current_stand/грубая схема принципа стенда.jpg

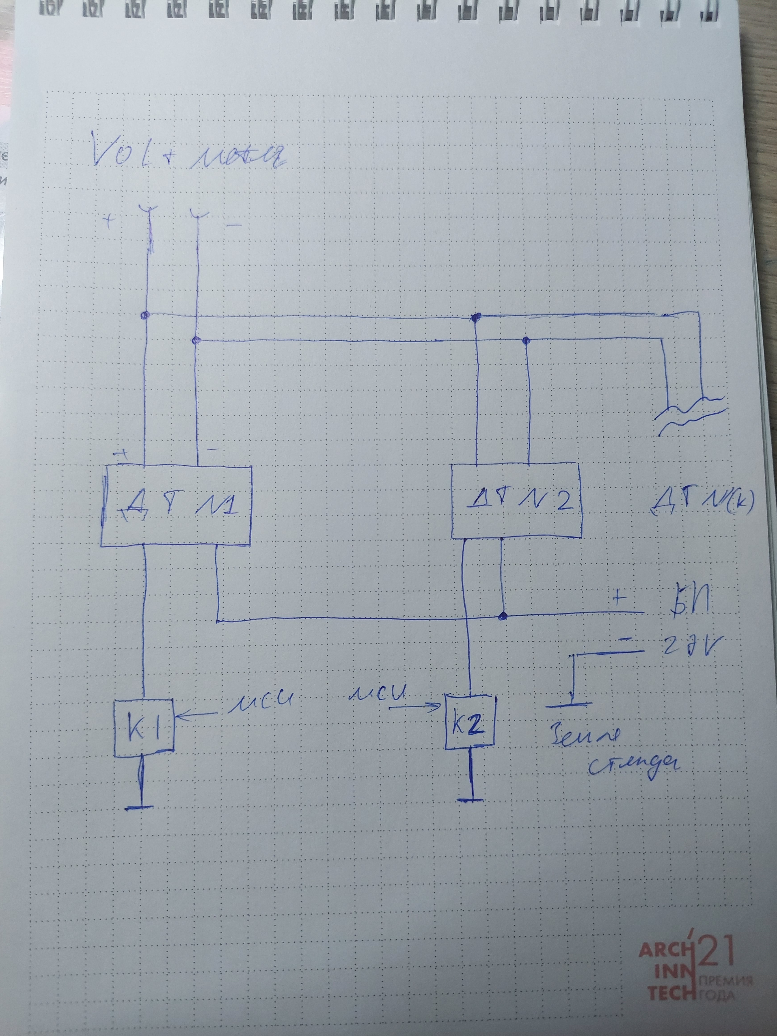
3 Elektronik/sensor_current_stand/грубая схема принципа стенда.jpg
